adho-bot/Individual-Project/report/Final_Report_11319192.odt

Bit-Serial SIMD Array Processor for Sobel Edge Detection Applications

Third Year Individual Project – Final Report

05/2026

11319192

Supervisor:

Piotr Dudek

## Contents

## Abstract

Real time systems operate under constraints, which may include area, power or computational load. This paper introduces a custom Pixel Processor Array (PPA) for convolution operations designed for area and power optimisation whilst balancing efficiency. Bit serial architectures are employed to reduce the power and by using an array processor based on the Single Instruction Multiple Data (SIMD) paradigm, computations can be accelerated with the bottlenecks apparent within bit-serial architectures. This paper demonstrates how different image processing kernels such as Gaussian blur, sharpening can be implemented without the use of conventional convolution. Results are shown through the Vivado simulator as well as Field Programmable Gate Arrays (FPGA) and Application Specific Integrated Circuit (ASIC) implementation

… To be continued after finishing the report

## Declaration of originality

I hereby confirm that this dissertation is my own original work unless referenced clearly to the contrary, and that no portion of the work referred to in the dissertation has been submitted in support of an application for another degree or qualification of this or any other university or other institute of learning.

## Intellectual property statement

i. The author of this thesis (including any appendices and/or schedules to this thesis) owns certain copyright or related rights in it (the “Copyright”) and s/he has given The University of Manchester certain rights to use such Copyright, including for administrative purposes.
ii. Copies of this thesis, either in full or in extracts and whether in hard or electronic copy, may be made only in accordance with the Copyright, Designs and Patents Act 1988 (as amended) and regulations issued under it or, where appropriate, in accordance with licensing agreements which the University has from time to time. This page must form part of any such copies made.
iii. The ownership of certain Copyright, patents, designs, trademarks and other intellectual property (the “Intellectual Property”) and any reproductions of copyright works in the thesis, for example graphs and tables (“Reproductions”), which may be described in this thesis, may not be owned by the author and may be owned by third parties. Such Intellectual Property and Reproductions cannot and must not be made available for use without the prior written permission of the owner(s) of the relevant Intellectual Property and/or Reproductions.
iv. Further information on the conditions under which disclosure, publication and commercialisation of this thesis, the Copyright and any Intellectual Property and/or Reproductions described in it may take place is available in the University IP Policy (see http://documents.manchester.ac.uk/DocuInfo.aspx?DocID=24420), in any relevant Dissertation restriction declarations deposited in the University Library, and The University Library’s regulations (see http://www.library.manchester.ac.uk/about/regulations/_files/Library-regulations.pdf).

## Acknowledgements

No need to include, but can if want to.

# Introduction

## Background and motivation

Convolution is a key operation in many image processing tasks. Many low level convolution operations are unordered tasks, making them suitable to parallel processing architectures. Traditional 2D convolution operations (where you shift a kernel across a grid of pixels) is computationally expensive, requiring large number of multiply-accumulate (MAC) operations per second, especially for high-resolution images and deep neural networks. There is a major bottleneck in scaling Convolutional Neural Networks due to significant power consumption challenges. In data centres, large deployment requires major electrical infrastructures and cooling systems due to limited energy efficiency when implemented on GPU clusters for training and inference. These challenges are even more apparent in edge devices, where strict power and silicon area constraints limit the feasibility of convolution operations.

## Aims and objectives

-AIM (What is the goals)

Target the inefficiencies

Area

Power

Speedup

-OBJECTIVES (How to achieve these goals)

Bit serial

Parallel

How to target each trade-off and what method you are using to do so

Bit-serial and reduced arithmetic approaches offer reductions in power and area usage, however increasing the trade-off, reducing the speed-up of the system. Therefore, careful consideration to the architecture must be employed to exploit parallelism and balance memory efficiency, power and silicon area. The work aims to develop a unique Bit-serial SIMD array processor for image processing applications.

Table Introduction.1. Example table.

Participant | Number / % | | Duration / %
| Prime dresses | Non-prime dresses | Prime dresses | Non-prime dresses
1 | 33.33 | 33.91 | 20.83 | 18.42
2 | 13.04 | 17.50 | 04.93 | 07.62
3 | 22.73 | 20.10 | 13.00 | 08.20
4 | 31.34 | 21.88 | 10.57 | 11.09
5 | 08.47 | 19.32 | 03.04 | 09.73
Mean | 16.4 | 16.5 | 07.8 | 07.5
Std. dev. | 09.7 | 06.6 | 05.4 | 03.3

Donec blandit feugiat ligula. Donec hendrerit, felis et imperdiet euismod, purus ipsum pretium metus, in lacinia nulla nisl eget sapien. Donec ut est in lectus consequat consequat. Etiam eget dui. Aliquam erat volutpat. Sed at lorem in nunc porta tristique. Proin nec augue. Quisque aliquam tempor magna. Pellentesque habitant morbi tristique senectus et netus et malesuada fames ac turpis egestas.

## Report structure

Lorem ipsum dolor sit amet, consectetuer adipiscing elit. Maecenas porttitor congue massa. Fusce posuere, magna sed pulvinar ultricies, purus lectus malesuada libero, sit amet commodo magna eros quis urna.

Nunc viverra imperdiet enim. Fusce est. Vivamus a tellus.

Pellentesque habitant morbi tristique senectus et netus et malesuada fames ac turpis egestas. Proin pharetra nonummy pede. Mauris et orci.

Aenean nec lorem. In porttitor. Donec laoreet nonummy augue.

Suspendisse dui purus, scelerisque at, vulputate vitae, pretium mattis, nunc. Mauris eget neque at sem venenatis eleifend. Ut nonummy.

This is an example equation. It is done inside a table with the table lines hidden.

| {a} ^ {2} + {b} ^ {2} = {c} ^ {2} | (Introduction.1)

Lorem ipsum dolor sit amet, consectetuer adipiscing elit. Maecenas porttitor congue massa. Fusce posuere, magna sed pulvinar ultricies, purus lectus malesuada libero, sit amet commodo magna eros quis urna.

Nunc viverra imperdiet enim. Fusce est. Vivamus a tellus.

Pellentesque habitant morbi tristique senectus et netus et malesuada fames ac turpis egestas. Proin pharetra nonummy pede. Mauris et orci.

Aenean nec lorem. In porttitor. Donec laoreet nonummy augue.

Suspendisse dui purus, scelerisque at, vulputate vitae, pretium mattis, nunc. Mauris eget neque at sem venenatis eleifend. Ut nonummy.

# Literature review

## Introduction

Lorem ipsum dolor sit amet, consectetuer adipiscing elit. Maecenas porttitor congue massa. Fusce posuere, magna sed pulvinar ultricies, purus lectus malesuada libero, sit amet commodo magna eros quis urna. Nunc viverra imperdiet enim.

Fusce est. Vivamus a tellus. Pellentesque habitant morbi tristique senectus et netus et malesuada fames ac turpis egestas. Proin pharetra nonummy pede.

Mauris et orci. Aenean nec lorem. In porttitor. Donec laoreet nonummy augue.

This is an example figure.

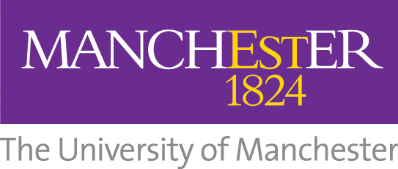
[picture p5: figure]

Fig. Literature review.1. Example figure.

## Detail

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

Nunc viverra imperdiet enim. Fusce est. Vivamus a tellus.

Pellentesque habitant morbi tristique senectus et netus et malesuada fames ac turpis egestas. Proin pharetra nonummy pede. Mauris et orci.

Aenean nec lorem. In porttitor. Donec laoreet nonummy augue.

Suspendisse dui purus, scelerisque at, vulputate vitae, pretium mattis, nunc. Mauris eget neque at sem venenatis eleifend. Ut nonummy.

## More detail

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

Nunc viverra imperdiet enim. Fusce est. Vivamus a tellus.

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

Aenean nec lorem. In porttitor. Donec laoreet nonummy augue.

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

## Summary

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

Nunc viverra imperdiet enim. Fusce est. Vivamus a tellus.

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

Aenean nec lorem. In porttitor. Donec laoreet nonummy augue.

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

# Methods

## Introduction

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

Nunc viverra imperdiet enim. Fusce est. Vivamus a tellus.

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

Aenean nec lorem. In porttitor. Donec laoreet nonummy augue.

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

## Detail

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

Nunc viverra imperdiet enim. Fusce est. Vivamus a tellus.

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

Aenean nec lorem. In porttitor. Donec laoreet nonummy augue.

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

## More detail

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

Nunc viverra imperdiet enim. Fusce est. Vivamus a tellus.

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

Aenean nec lorem. In porttitor. Donec laoreet nonummy augue.

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

## Summary

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

Nunc viverra imperdiet enim. Fusce est. Vivamus a tellus.

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

Aenean nec lorem. In porttitor. Donec laoreet nonummy augue.

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

# Results and discussion

## Introduction

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

Nunc viverra imperdiet enim. Fusce est. Vivamus a tellus.

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

Aenean nec lorem. In porttitor. Donec laoreet nonummy augue.

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

## Detail

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

Nunc viverra imperdiet enim. Fusce est. Vivamus a tellus.

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

Aenean nec lorem. In porttitor. Donec laoreet nonummy augue.

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

## More detail

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

Nunc viverra imperdiet enim. Fusce est. Vivamus a tellus.

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

Aenean nec lorem. In porttitor. Donec laoreet nonummy augue.

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

## Summary

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

Nunc viverra imperdiet enim. Fusce est. Vivamus a tellus.

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

Aenean nec lorem. In porttitor. Donec laoreet nonummy augue.

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

# Conclusions and future work

## Conclusions

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

Nunc viverra imperdiet enim. Fusce est. Vivamus a tellus.

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

Aenean nec lorem. In porttitor. Donec laoreet nonummy augue.

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

## Future work

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

Nunc viverra imperdiet enim. Fusce est. Vivamus a tellus.

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

Aenean nec lorem. In porttitor. Donec laoreet nonummy augue.

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

## References

Put references here.

## Appendices

A Project outline

Project outline as submitted at the start of the project is a required appendix. Put here.

B Risk assessment

Risk assessment is a required appendix. Put here.

C XXXX – etc.
