adho-bot/Individual-Project/Final_Report_Latex/images/Array_Architecture.pdf

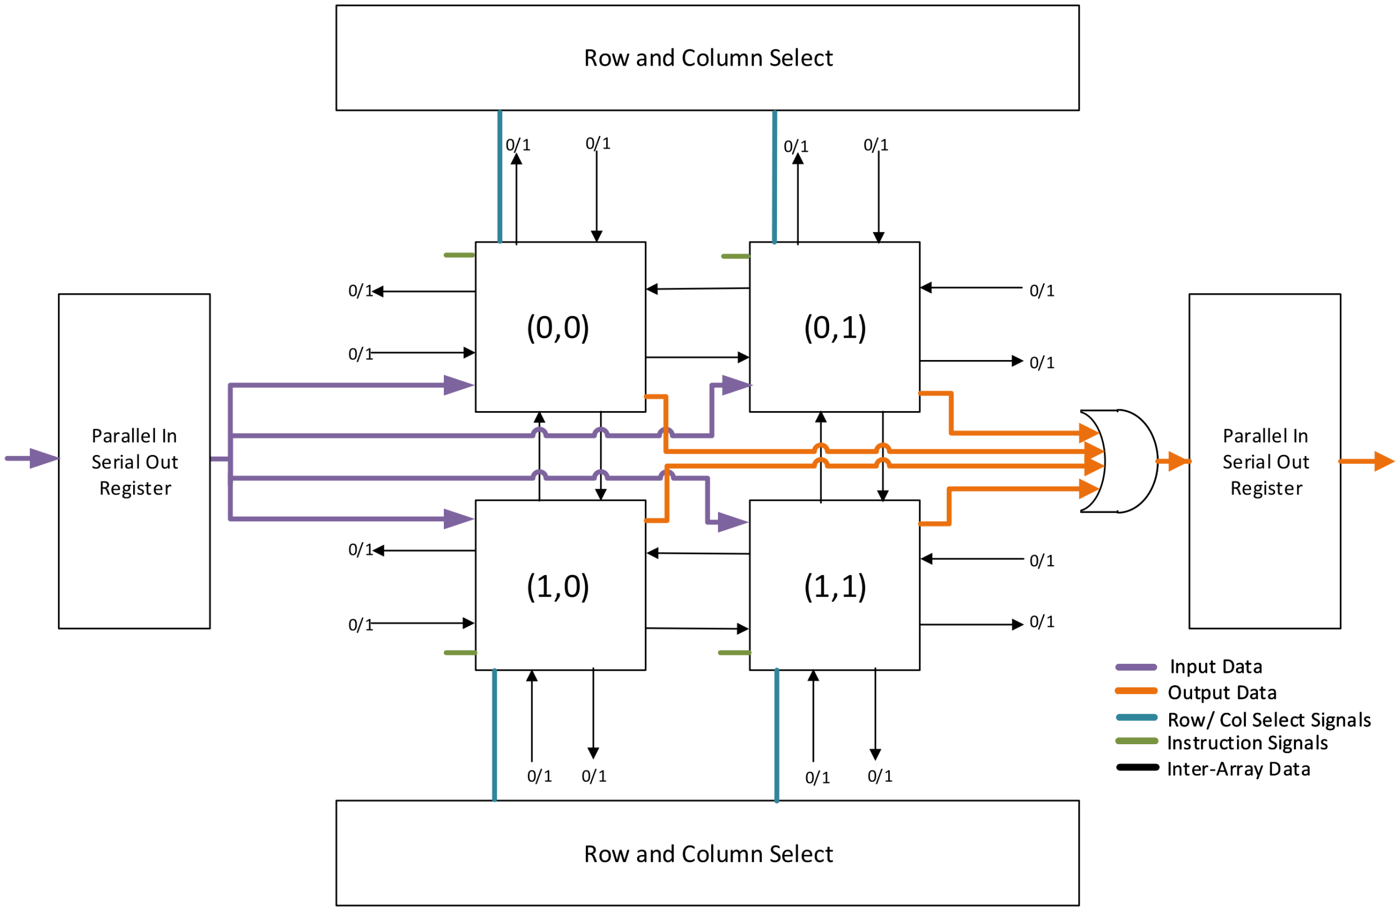
[picture p6: page 1]
