adho-bot/Individual-Project/Final_Report_Latex/images/CPD.pdf

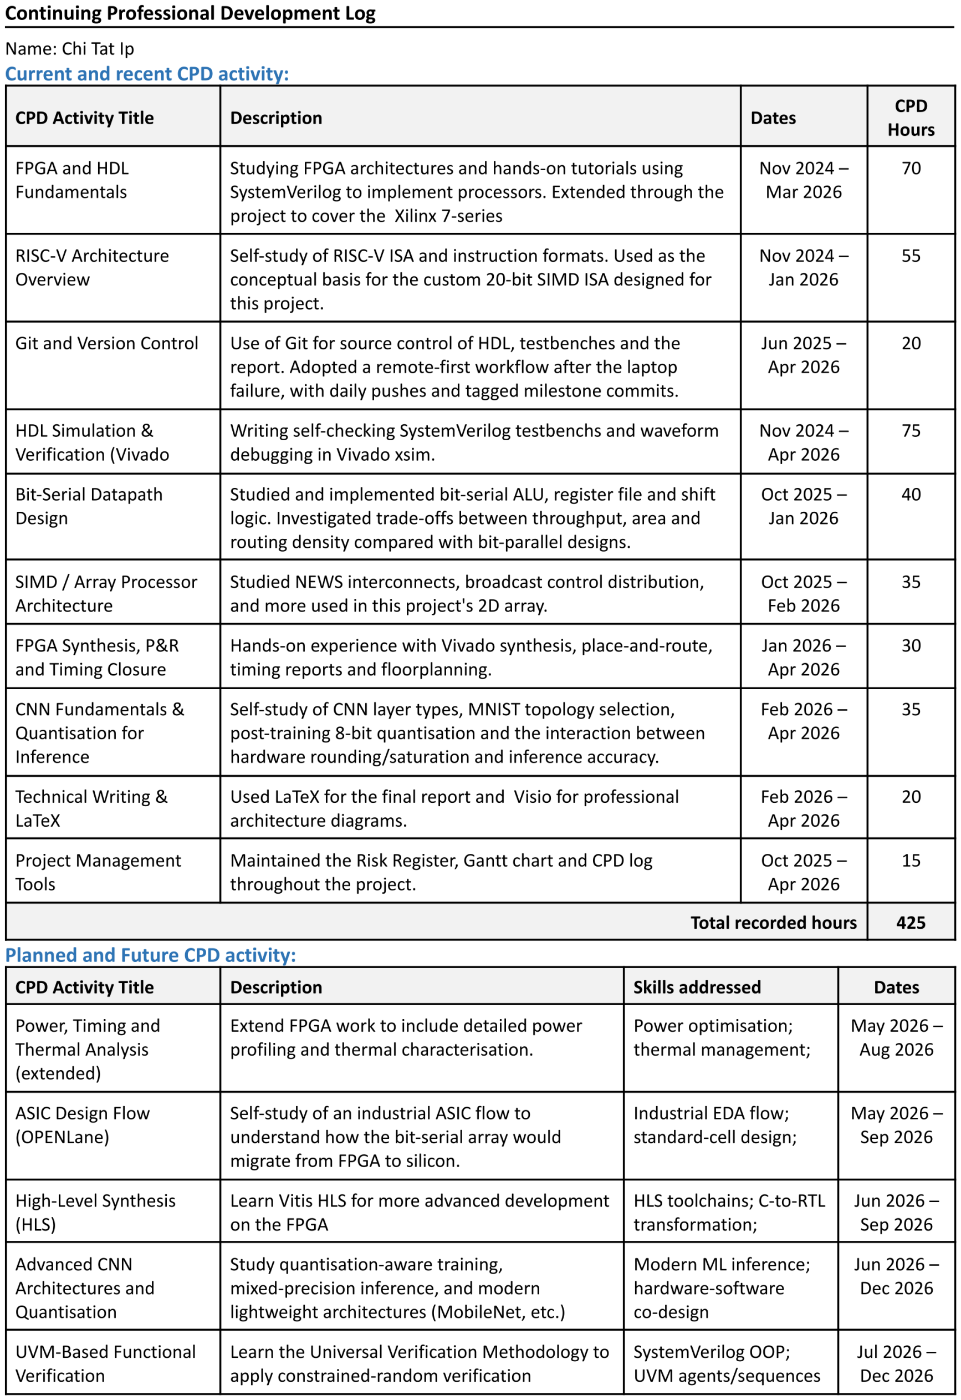
[picture p7: page 1]
