adho-bot/Individual-Project/Final_Report_Latex/images/FSM.pdf

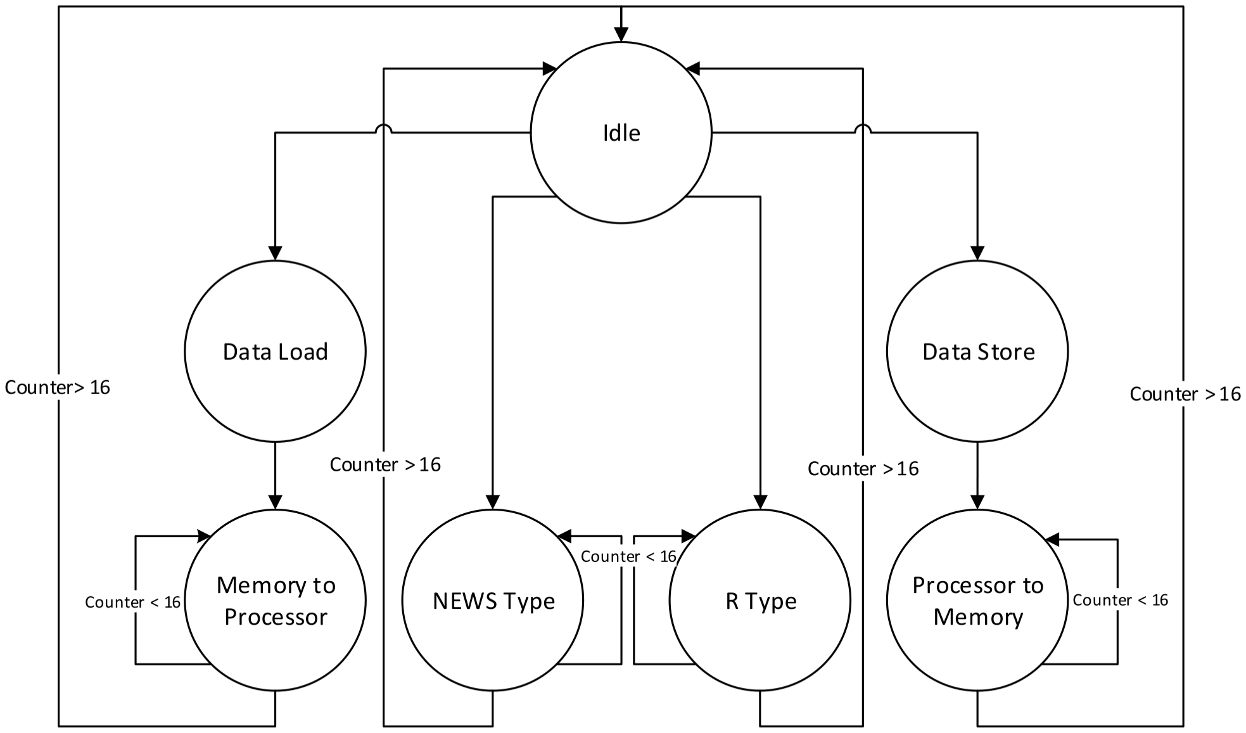
[picture p8: page 1]
