adho-bot/Individual-Project/Final_Report_Latex/images/Full_Individual_Project_Diagram.pdf

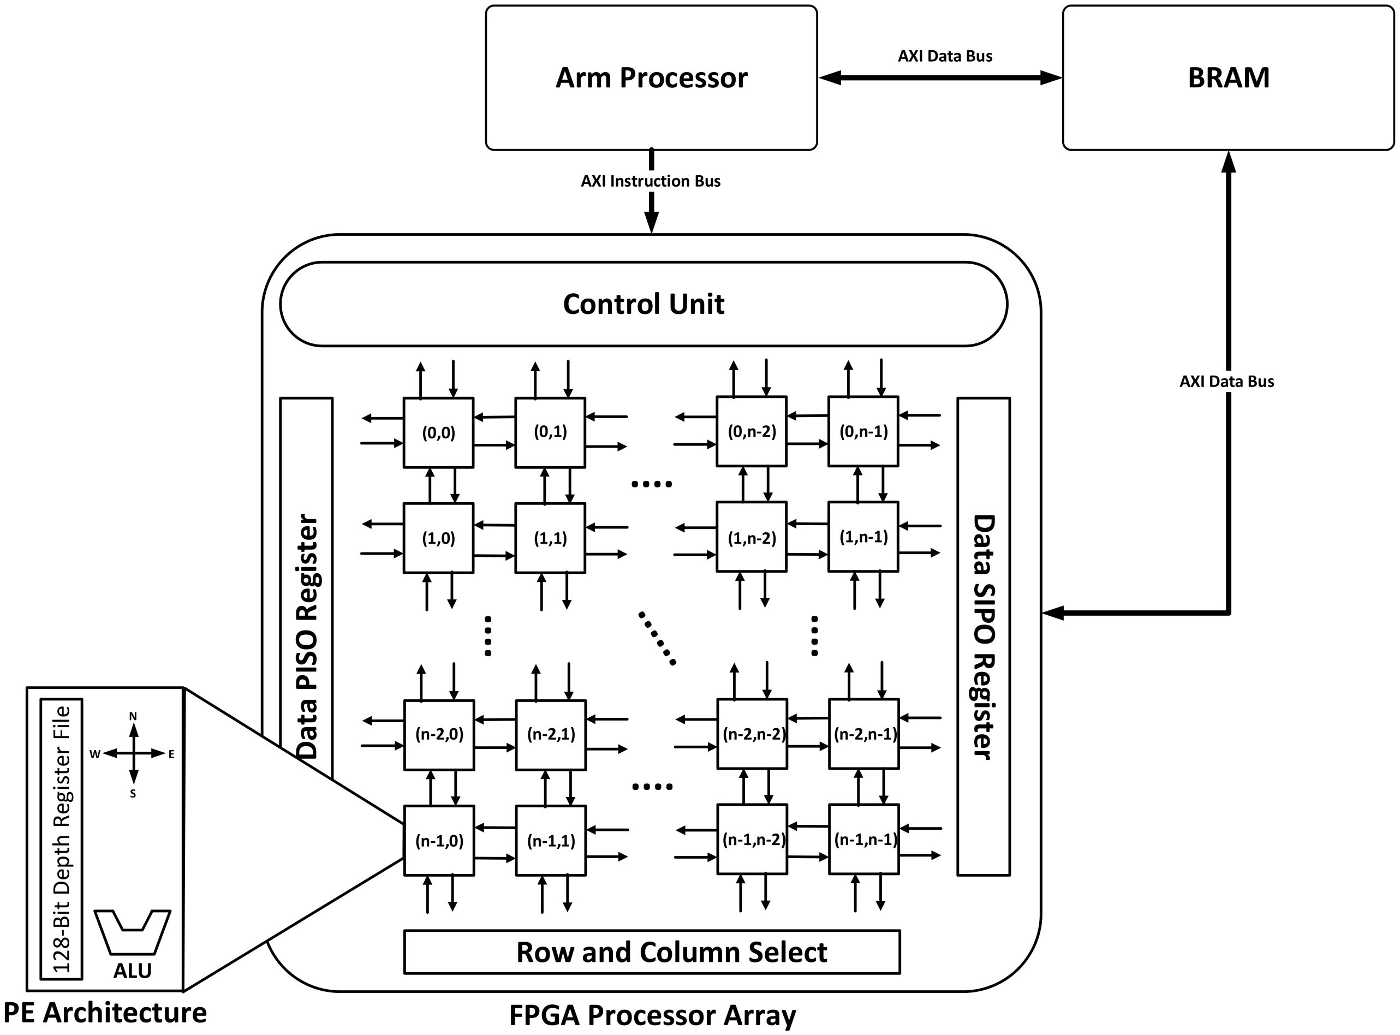
[picture p9: page 1]
