adho-bot/Individual-Project/Final_Report_Latex/images/PE_Architecture.pdf

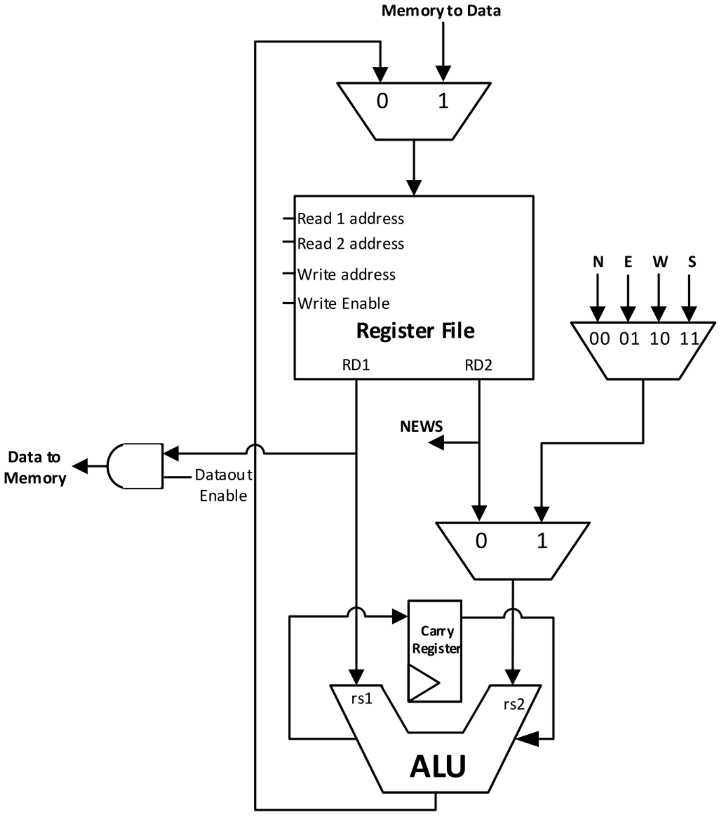
[picture p10: page 1]
