adho-bot/Individual-Project/Final_Report_Latex/images/SLICES.pdf

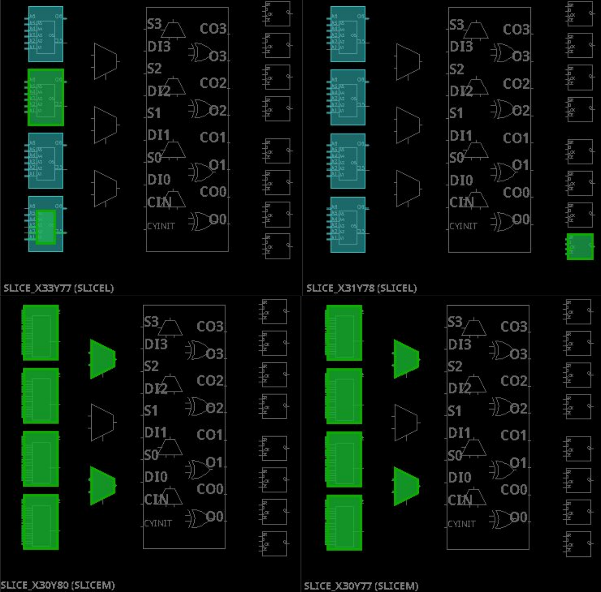
[picture p12: page 1]
