adho-bot/Individual-Project/Final_Report_Latex/images/System_Layout.pdf

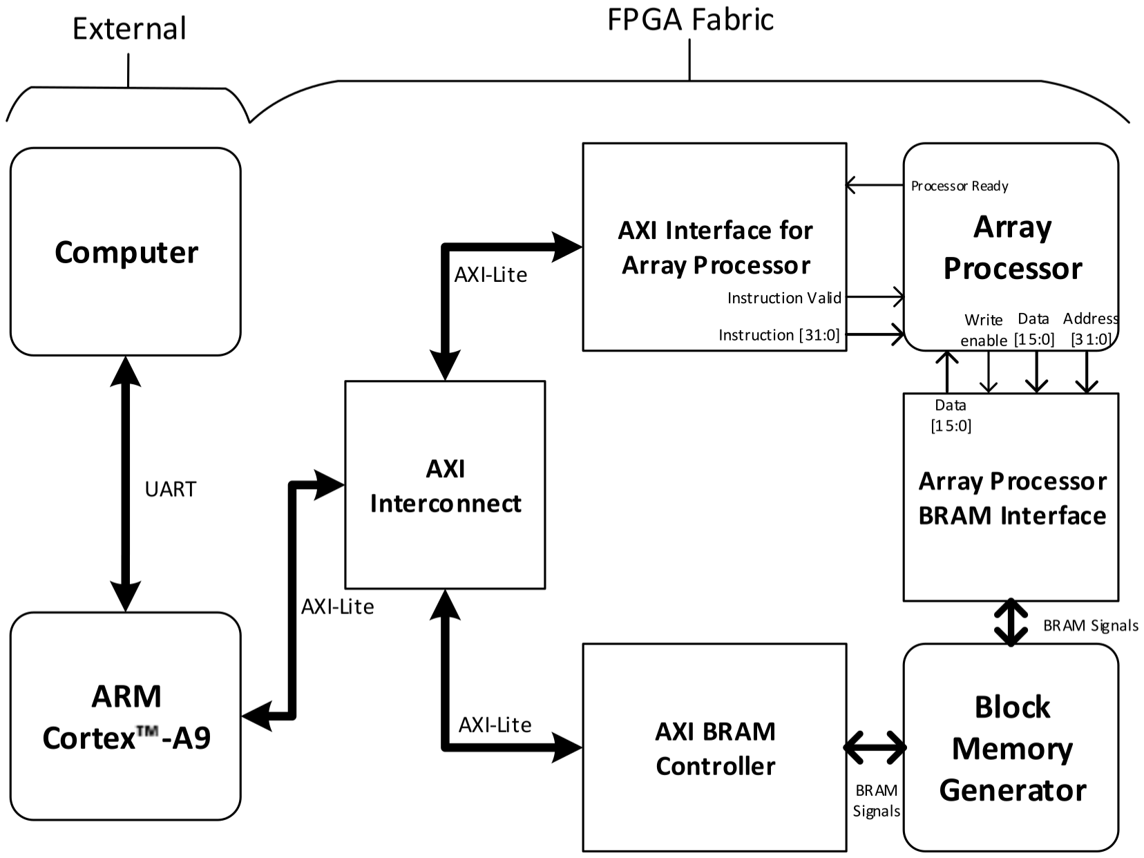
[picture p13: page 1]
