adho-bot/Individual-Project/An_Area_and_Power_Efficient_Bit_Serial_SIMD_Array_Processor_for_Image_Processing_on_FPGA.pdf

## An Area and Power-Efficient Bit-Serial SIMD Array Processor for

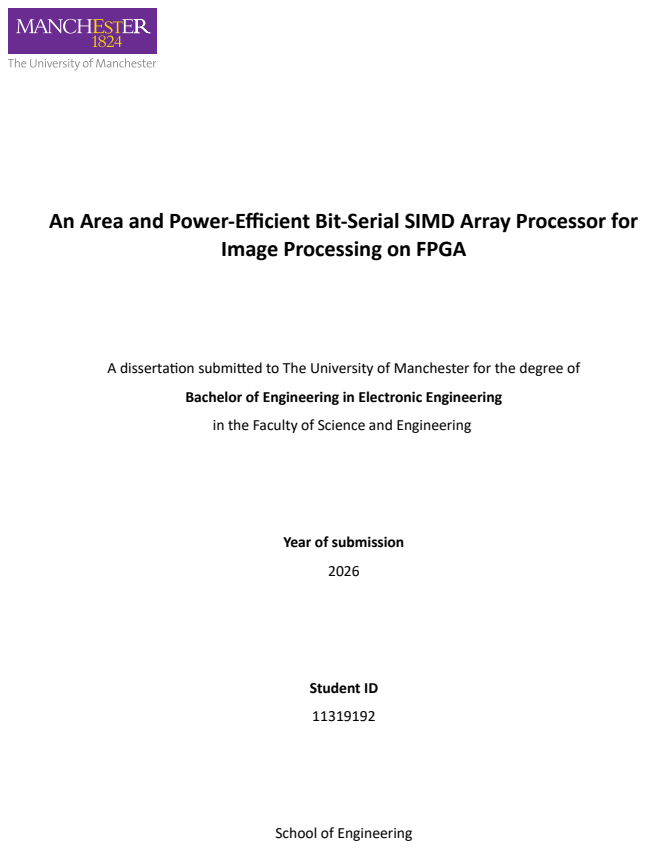
[picture p14: page 1]
Student ID

Image Processing on FPGA

A dissertation submitted to The University of Manchester for the degree of

Bachelor of Engineering in Electronic Engineering

in the Faculty of Science and Engineering

Year of submission

School of Engineering

## Contents

Word count: 11014

## Abstract

Image processing in edge-intelligent systems, such as wearable devices and remote sensors, de-

mands high throughput when operating within low power envelopes. Using conventional sequen-

tial processor architectures introduces disproportionate area and energy costs for workloads whose

parallelism is fundamentally data-level and spatial. This dissertation presents the design and anal-

ysis of a custom bit-serial SIMD array processor targeted at the optimisation of these three con-

straints for low-level image processing workloads.

The architecture exploits data-level parallelism through a two-dimensional grid of processing ele-

ments with NEWS connectivity, a 20-bit instruction set supporting movement-based convolution,

and a distributed register file mapped to LUTRAM to minimise per-PE footprint. The design is im-

plemented on a Xilinx XC7Z020 (PYNQ-Z2), characterised across five array configurations from 4 to

1024 PEs, and evaluated on Sobel edge detection and a shallow MNIST convolutional classifier. At

1024 PEs the processor delivers a word-level throughput of 2.42 GOPS at 71 MHz while consum-

ing 92 mW and occupying 47.1% of available LUTRAM and 31.7% of logic LUTs. Peak energy effi-

ciency reaches 0.0507 GOPS/mW at intermediate configurations. Three architectural bottlenecks,

the single-word memory interface, OR-tree depth, and AXI-Lite handshake latency, are quantified

with targeted architectural solutions proposed. The results demonstrate that fine-grained bit-serial

SIMD remains a competitive operating point for area and power constrained image processing on

FPGAs.

## List of figures

1 | Example labelled numbers from the MNIST dataset | | 18
2 | System and array processor overview | | 20
3 | Array Processor High Level Architecture | | 21
4 | Processing Element Datapath Architecture | | 22
5 | Finite State Machine for the Array Processor | | 24
6 | Instruction Types for the Array Processor | | 25
7 | System implementation for array processor. Important data, control and bus interface
| signals are presented. Bold arrows represent buses consisting of multiple signal types . | 27
8 | Slice composition of a single PE. Top two slices are SLICEL, bottom two are SLICEM; PE
| resources are highlighted in green neighbouring PE resources in teal | | 36
9 | Cycle distribution by FSM state for the Sobel and number-classification workloads. The
| Sobel filter is executed on the 32×32 (1024-PE) configuration; the classifier is executed
| on the 16×16 (256-PE) configuration. Arithmetic combines R-type and NEWS-type in-
| structions; I/O combines load and store; IDLE counts cycles in which no instruction is
| executing | | 37
10 | FPGA resource utilisation as a function of array size. Logic LUTs, LUTRAMs, flip-flops,
| and slices are reported for five PE configurations (4, 16, 64, 256, 1024). Lines are linear
| regressions in log–log space | | 39
11 | Theoretical peak bit-level throughput as a function of array size. The dashed line is a
| linear regression in log–log space | | 39
12 | Dynamic power consumption as a function of array size. Power is reported for the ar-
| ray and control unit only, measured using a vectorless method. The dashed line is a
| linear regression in log–log space | | 40
13 | Sobel edge detection on a 32x32 picture of an eye. Input shown on the left. Result
| shown on the right | | 41
14 | Number classification for the 16x16 digit eight. Input shown on the left. Result shown
| on the right | | 41
15 | Gantt chart for the bit-serial array processor during semester 1 | | 51
16 | Gantt chart for the bit-serial array processor during semester 2 | | 51
17 | Risk Assessment Form | | 52
18 | Risk Register | | 53
19 | Continuing Professional Development (CPD) log | | 54

## List of tables

1 | Bit-serial array processors | | 16
2 | Modern array processors | | 17
3 | Instruction Set Summary | | 26
4 | Theoretical vs Measured CPI by Instruction | | 36
5 | BRAM word-address memory map | | 57
6 | PE register allocation during CNN inference | | 58

## List of Abbreviations

ALU | Arithmetic Logic Unit
ASIC | Application-Specific Integrated Circuit
AXI | Advanced eXtensible Interface
BRAM | Block Random Access Memory
CLB | Configurable Logic Block
CNN | Convolutional Neural Network
CPI | Cycles Per Instruction
FPGA | Field-Programmable Gate Array
FSM | Finite State Machine
GOPS | Giga-Operations Per Second
ISA | Instruction Set Architecture
LUT | Look-Up Table
LUTRAM | Look-Up Table Random Access Memory
MAC | Multiply-Accumulate
MIMD | Multiple Instruction, Multiple Data
MNIST | Modified National Institute of Standards and Technology
NEWS | North, East, West, South
PE | Processing Element
PISO | Parallel-In Serial-Out
ReLU | Rectified Linear Unit
RTL | Register Transfer Level
SIMD | Single Instruction, Multiple Data
SIPO | Serial-In Parallel-Out

## Declaration of originality

I hereby confirm that no portion of the work referred to in the thesis has been submitted in sup-

port of an application for another degree or qualification of this or any other university or other

institute of learning.

## Copyright statement

i The author of this thesis (including any appendices and/or schedules to this thesis) owns cer-

tain copyright or related rights in it (the “Copyright”) and s/he has given The University of

Manchester certain rights to use such Copyright, including for administrative purposes.

ii Copies of this thesis, either in full or in extracts and whether in hard or electronic copy, may

be made only in accordance with the Copyright, Designs and Patents Act 1988 (as amended)

and regulations issued under it or, where appropriate, in accordance with licensing agree-

ments which the University has from time to time. This page must form part of any such copies

made.

iii The ownership of certain Copyright, patents, designs, trademarks and other intellectual prop-

erty (the “Intellectual Property”) and any reproductions of copyright works in the thesis, for

example graphs and tables (“Reproductions”), which may be described in this thesis, may not

be owned by the author and may be owned by third parties. Such Intellectual Property and

Reproductions cannot and must not be made available for use without the prior written per-

mission of the owner(s) of the relevant Intellectual Property and/or Reproductions.

iv Further information on the conditions under which disclosure, publication and commercial-

isation of this thesis, the Copyright and any Intellectual Property and/or Reproductions described in it may take place is available in the University IP Policy (see http://documents.
manchester.ac.uk/DocuInfo.aspx?DocID=24420), (http://documents.manchester.ac.uk/DocuInfo.aspx?DocID=24420) in any relevant Thesis restriction dec-

larations deposited in the University Library, The University Library’s regulations (see http:

## //www.library.manchester.ac.uk/about/regulations/) and in The University’s policy

on Presentation of Theses.

## Acknowledgments

I would like to thank my project supervisor Dr. Piotr Dudek for his amazing guidance and invaluable

expertise, throughout this project.

## 1 Introduction

Critical edge applications such as wearable medical devices, and remote sensors, must operate

within constrained power and space limits while responding in real time. These devices cannot rely

on processing on cloud servers because transmitting data can be slow or unreliable. Edge-intelligent

systems address this by processing data locally, allowing for fast computation whilst minimising

power and area consumption. To meet these requirements, parallel processor arrays (PPAs) and

SIMD architectures are well suited. Their grid-like structure and ability to run many calculations in

parallel make them ideal for tasks such as image processing in real-time embedded systems.

### 1.1 Background and Motivation

Image processing is the core workload of various edge systems. 2D convolution is the fundamental

operation found in low-level vision and convolutional neural network (CNN) tasks. This is where

a weighted sum of a pixel and its neighbours are repeated across the entire image. A single 3×3

convolution on a modest 256×256 image already requires over half a million multiply-accumulate

(MAC) operations, and modern CNNs scale this by orders of magnitude through multiple stacked

convolutional layers and feature channels. Executing such workloads on conventional sequential

processors is very inefficient. Pipelining, superscalar issue, and out-of-order execution all target

instruction-level parallelism, but they do not exploit the property that the same operation is ap-

plied independently to many data elements.

Single-Instruction-Multiple-Data (SIMD) array processors exploit this property directly. A grid of

processing elements (PEs) executes one shared instruction across many pixels in parallel, elimi-

nating the per-instruction fetch and decode cost. When the array is connected through nearest-

neighbour links, the spatial structure of convolution maps onto the hardware without the need for

global memory access.

### 1.2 Aims and Objectives

The aim of this project is to design, implement, and evaluate an area and power efficient FPGA-

based bit-serial SIMD array processor capable of executing image-processing workloads. Each ob-

jective is benchmarked against prior bit-serial FPGA designs (where possible) and against three cri-

teria: area efficiency (resource consumption per processing element), energy efficiency (operations per unit power, GOPS/mW), and performance (Giga Operations Per Second, GOPS). The objectives

for the design are as follows:

1. Bit-serial processing element: Design a simple processing element comprising a bit-serial ALU

supporting arithmetic and boolean logic alongside a bit-serial register file. Success is defined

as a functionally correct Processing Element (PE) that passes testcases across all supported

ALU operations and performs proper reads and writes to the register file, while achieving a

per-PE slice and Look-Up-Table (LUT) footprint competitive with prior bit-serial FPGA designs.

2. Scalable NEWS-connected array: Replicate the PE into a two-dimensional grid with North,

East, West, South (NEWS) connectivity, with a configurable boundary padding scheme and PE

activity gating for inactive elements. Success is defined as fitting a large array configuration,

sized against current bit-serial processors, within the available resources, delivering through-

put in GOPS that scales with PE count while keeping dynamic power consumption (in mW)

low enough to yield a competitive GOPS/mW figure.

3. Hardware control unit and instruction set architecture: Develop an FSM-based controller

with a minimal instruction set sufficient to run complex workloads, sequence bit-serial PE ex-

ecution, and provide a ready/valid handshake to the host. Success is defined as full ISA cov-

erage through workload execution, with the controller correctly driving all datapath control

signals.

4. ARM-host system integration: Connect the array processor to the ARM Cortex-A9 on the PYNQ-

Z2 using AXI-Lite for instruction delivery and a true-dual-port BRAM for data exchange. Suc-

cess is defined as a working host-accelerator system in which C programs running on the ARM

core can issue instructions and read back results, with the integration logic fitting within the

target device alongside the full array.

5. Application demonstration and evaluation: Implement two image processing workloads on

the completed system: a 3x3 Sobel edge-detection filter and a shallow convolutional neural

network for MNIST digit classification. Success is defined as both workloads producing the ex-

pected results: visible edges in the Sobel output and predicted digits matching the input la-

bels.

### 1.3 Report Structure

Section 2 examines the different approaches taken by researchers who have built SIMD processors,

based on a review of the literature. Section 3 describes the methodology in detail, including the

processor architecture, as well as the instruction set, control mechanisms, system architecture and

image processing algorithms. Section 4 presents benchmarking results, bottleneck discussion and

a threats-to-validity analysis. Section 5 goes through the different management techniques used,

such as Gantt charts, risk registers and CPD logs, to monitor progress and ensure the project re-

mained on schedule. Finally, Section 6 summarises the findings from all sections and discusses po-

tential future improvements.

## 2 Literature review

### 2.1 Introduction

Conventional sequential processors are designed to execute instructions one at a time. Improve-

ments to the traditional processor have been made to accelerate data throughput and instruction

execution. Techniques such as pipelining, superscalar and out of order execution have been utilised,

however, these approaches primarily target instruction level parallelism and not data level par-

allelism. Array processors are built upon the SIMD paradigm described in Flynn’s Taxonomy [1],

where multiple PEs act upon different pieces of data based on a single shared instruction stream.

This architecture is designed to perform high-throughput computations on large data arrays through

exploiting data level parallelism for tasks like image processing. Common types of SIMD processors

include array processors, pipelined processors, and associative processors. [2]

Array processors contain a regular structure of Processing Elements (PE). Each PE typically contains

a local register or memory, an arithmetic logic unit (ALU), and commonly north, east, south, west

cardinal communication channels to neighbouring PEs. This allows for efficient local data move-

ment without relying on slower global memory accesses as large amounts of data can be computed

within the PEs without the need for loading and storing to memory. These architectural features

make array processors highly suitable for operations that involve spatial computations, where the

resultant values depend on the current pixel as well as its neighbours. This dissertation will focus

on architectures related to the SIMD array processor.

### 2.2 A Review of SIMD Array Processors

Over the decades, SIMD array architectures have evolved from bit-serial designs to more complex

word-parallel architectures capable of performing more sophisticated arithmetic operations and

tasks. Differences in PE count, clock frequency, local memory size, and interconnect topology play

a critical role in determining the performance and efficiency of each implementation. Examining

these metrics shows that improvements have been made toward greater scalability, computational

efficiency, and suitability for image processing workloads.

### 2.2.1 Performance Metrics and Architectural Features of Past Arrays

Several early array processors were designed around the bit-serial SIMD paradigm, where each PE

operates on one bit per clock cycle, requiring multiple cycles to complete even a basic 8-bit arith-

metic operation. This architectural trade-off was made intentionally. Through reducing the width of

the buses within the PE, the effective area was reduced, allowing designers to integrate more PEs

into a processor. The processors introduced in Table 1 follow the bit-serial SIMD execution model.

The latency of data movement between PEs is highly dependent on the interconnect topology. The

Massively Parallel Processor (MPP) [3], Geometric Arithmetic Parallel Processor (GAPP) [4], and Dis-

tributed Array Processor (DAP) [5] utilise a mesh connectivity topology, with each PE being con-

nected to four of its neighbours. While being simple to implement, it was only efficient for local

operations as shifting data across the array was computationally expensive. On the other hand,

CM-1 [6] and CM-2 [7] used a hypercube routing method, organising PEs across an n-dimensional

binary cube, thus reducing the hop count between distant nodes. In the 65,536-PE CM-2, a 16-

dimensional hypercube meant the worst-case inter-PE distance was 16 hops, compared to 510 for

the mesh topology.

The GAPP ran at 0.0576 GOPS with 144 PEs on a single chip with 128 bits of local memory. It was

intended for embedded image processing applications, hence the architecture focused on area and

power consumption. The DAP increased the number of PEs and local memory size to 4,096, conse-

quently, increasing the throughput to 0.759 GOPS compared to the GAPP.

The MPP was a 128 x 128 mesh with 1K bits of local storage per PE. It reached 6.555 GOPS at 10

MHz on 8-bit data. The CM-1 followed in 1985, with 65,536 PEs connected by a hypercube topol-

ogy, 5 MHz clock frequency but increasing the throughput to 8 GOPS. The CM-2 retained the same number of PEs with a slightly increased clock frequency compared to the CM-1 but drastically in-

creased its throughput to 45.8 GOPS. due to the addition of floating-point chips (one per 32 PEs).

This showed that dedicated arithmetic hardware offered more than simply increasing the number

of PEs.

Table 1. Comparison of past bit-serial SIMD array processors for 8-bit processing.

Processor | Processing
| Elements | Clock (MHz) | PE Local
| | | Memory | Interconnect | Throughput
| | | | | (GOPS)
MPP | 16384 | 10 | 1K bits | 2D mesh | 6.554
CM-1 | 65536 | 5 | 4K bits | Hypercube | 8
CM-2 | 65,536 | 7 | 64K bits | Hypercube | 45.86
GAPP | 144 | 10 | 128 bits | 2D mesh | 0.0576
DAP | 4096 | 5 | 4096 bits | 2D mesh | 0.759

### 2.2.2 Performance Metrics and Architectural Features of Modern Arrays

Most modern parallel accelerators have shifted from the SIMD model of the historical arrays to

MIMD or hybrid execution, driven by the workload diversity of machine learning training and infer-

ence [8], [9]. The Graphcore GC200 [8], [10] integrates 1,472 independent multi-threaded tiles con-

nected through a stateless all-to-all fabric, delivering 250 TFLOPS at FP16 with 900 MB of on-chip

SRAM. The Cerebras WSE-2 [11], [12] occupies the opposite extreme: 850,000 MIMD tiles in a 2D

mesh on a single 46,225 mm² wafer, sustaining 7.5 PFLOPS. The SambaNova SN40L [9], [13] adopts

a coarse-grained reconfigurable dataflow architecture, delivering 638 TFLOPS through a compiler-

configured interconnect. SCAMP-5 [14] is the principal exception to the MIMD trend: a 256x256

SIMD array of 65,536 mixed-signal PEs delivering over 500 GOPS at sub-watt power through tightly

integrated sensing, memory, and compute.

Table 2 summarises these designs. Of these, only SCAMP-5 is a direct architectural comparator to

the present work; the others are included to characterise the broader landscape and the design

pressures that motivated the shift away from SIMD.

Table 2. Comparison of modern array processors.

Processor | PEs | Clock (MHz) | PE Local
| | | Memory
Interconnect | Throughput
SCAMP-5 [14] | 65,536 | 10 | 20 registers | 2D mesh | 0.655 TOPS
GC200 [8] | 1,472 | 1,330 | 624 KiB | All to all | 250 TFLOPS
WSE-2 [11] | 850,000 | ∼850 | 48 KB | 2D mesh | 7,500 TFLOPS
SN40L [13] | 1,040 | ∼1,000 | 520 MB
| | | Shared | Reconfig-
| | | | urable | 638 TFLOPS

### 2.2.3 Bit-Serial SIMD on FPGA

A small number of works have explored bit-serial SIMD specifically on FPGA, occupying a design

point distinct from both the historical ASIC arrays of Section 2.2.1 and the modern accelerators

of Section 2.2.2. Walsh and Dudek [15] present a 32x32 bit-serial SIMD array on a Xilinx Virtex-

5 (XC5VLX50), with each PE encapsulated in two CLBs (four slices) and connected through four-

neighbour NEWS topology. The design operates at 150 MHz and achieves a peak bit-serial through-

put of 153.6 GOPS, demonstrating binary and 8-bit greyscale image processing. The architecture

targets compactness and raw frequency, and serves as the most direct comparator to the work pre-

sented in this dissertation.

SPAR-2 [16] and its successor IMAGine [17] take a different approach, pairing bit-serial ALUs with

distributed BRAMs as a processing-in-memory overlay rather than a NEWS-connected mesh. SPAR-

2 is a programmable overlay for machine learning workloads on edge FPGAs, while IMAGine reaches

737 MHz on AMD Alveo U55 hardware with 64K bit-serial MAC units, optimised for matrix-vector

operations rather than pixel-parallel image processing.

### 2.2.4 Comparison Between Array Implementations

Three key trends emerge when comparing the architectures surveyed in Sections 2.2.1–2.2.3. First,

modern designs trade PE count for more complex PEs. The GC200 delivers over many orders of

magnitude greater throughput than the MPP with fewer than one-tenth the PE count, although the

comparison is across different precision regimes (FP16 versus 8-bit integer). Second, the choice of

interconnect reflects the type of workload performed. 2D mesh architectures scale well in hardware, but they introduce communication delays between distant PEs. This is acceptable for locally

connected tasks like CNNs (e.g., SCAMP-5 and WSE-2), where most data stays nearby. However,

it becomes inefficient for operations that require all-to-all communication, like the GC200’s cross-

bar and the SN40L’s reconfigurable interconnect. Third, on-chip memory capacity has become the

principal architectural differentiator. Off-chip DRAM accesses cost two to three orders of magni-

tude more energy per byte than SRAM [18] as well as possessing a longer data fetch latency. Bit-

serial SIMD designs sidestep this trade-off by keeping data local to each PE, with movement han-

dled through nearest-neighbour connectivity. The work presented in this dissertation is therefore

not designed to compete with the modern accelerators of Section 2.2.2. It positions itself most

directly against the FPGA bit-serial designs of Section 2.2.3, against which it is quantitatively com-

pared in Section 4.6.

### 2.3 MNIST and Convolutional Neural Networks

The Modified National Institute of Standards and Technology (MNIST) database is a collection of

grey-scale images of handwritten digits. Constructed by LeCun et al. from the larger NIST Special

Databases 1 and 3, each digit is contained within a 20x20 box, and centred by mass within a 28x28

canvas [19]. The final dataset contains 60,000 training and 10,000 test examples, labelled with num-

bers ranging from 0 to 9 [20]. Its compact size and well-established baselines make it perfect for

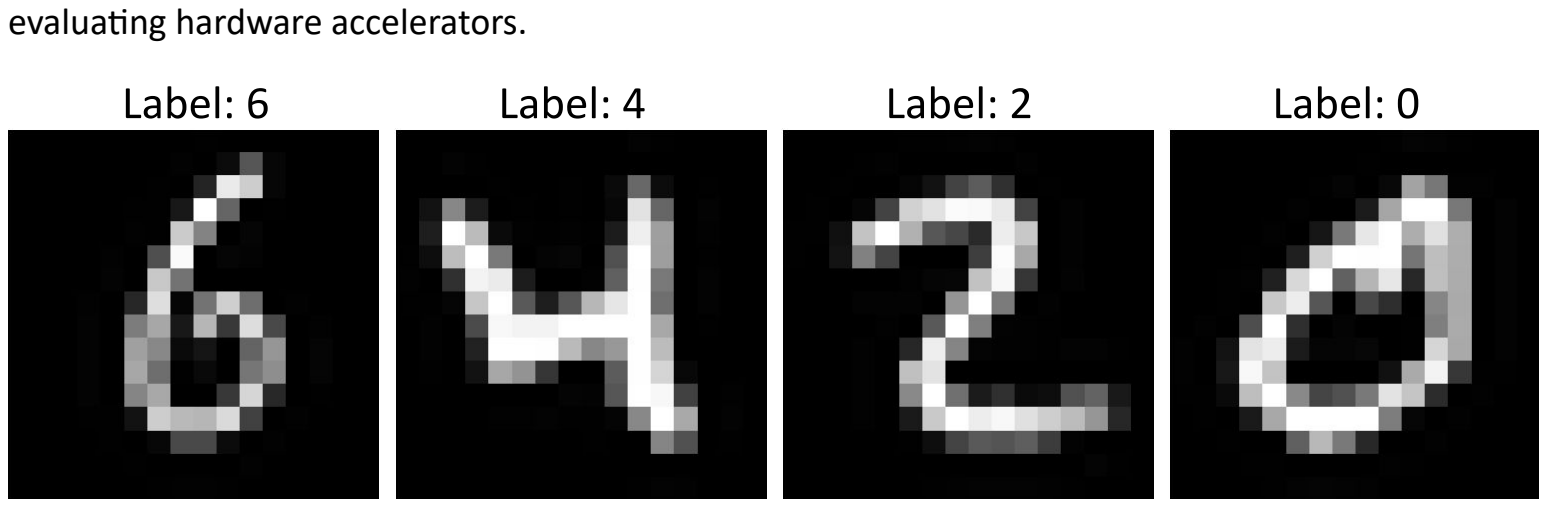
[picture p15: figure]
evaluating hardware accelerators.

Fig. 1. Example labelled numbers from the MNIST dataset

Convolutional Neural Networks (CNNs), trained end-to-end using back-propagation, make use of

the spatial structure in image data through three key ideas: local receptive fields, shared weights,

and spatial subsampling [19]. A classic example is LeNet-5, introduced by LeCun et al. in 1998, which

combines convolutional and subsampling layers with fully connected layers for classification. It

achieves less than 1% error on the MNIST dataset [19].

The computation in CNNs is mainly made up of regular multiply–accumulate operations applied

across 2D feature maps. This structure maps well onto a SIMD array, since the same operation is

repeated independently across many pixels. In this design, the NEWS interconnect is used to pass

data between neighbouring PEs, avoiding the need for global memory accesses during convolution.

In addition, the bit-serial datapath allows precision to be adjusted depending on the layer, trading

accuracy for performance when needed. Since MNIST inference is known to be robust to reduced

precision, it is a suitable benchmark for evaluating the array processor, as discussed in Chapter 4.

### 2.4 PYNQ-Z2 Architecture

The PYNQ-Z2 is the chosen development board for this project, pairing a 650 MHz dual-core ARM

Cortex-A9 with a Xilinx Zynq-7020 FPGA fabric containing 53,200 Look-Up Tables (LUTs), 106,400

flip-flops, and 140 Block RAMs [21].

The Zynq-7020 uses Xilinx’s Advanced Silicon Modular Block (ASMBL) architecture, in which Config-

urable Logic Blocks (CLBs) are organised in columns alongside dedicated BRAM and DSP resources

to improve routing efficiency [22]. Each CLB contains two slices, and slices come in two variants:

SLICELs provide LUTs, flip-flops, multiplexers, and carry logic, while SLICEMs additionally allow their

LUTs to be configured as shift registers or distributed RAM (LUTRAM) [22].

The SIMD array processor is synthesised entirely within the programmable logic, with each PE mapped

onto LUT and flip-flop resources and inter-PE communication routed through the fabric. As the

array scales, routing complexity and placement constraints become significant factors affecting

achievable frequency and resource utilisation.

### 2.5 Summary

The literature review in this chapter demonstrates the evolution of parallel processing architec-

tures from early bit-serial SIMD array processors to modern large-scale heterogeneous accelera-

tors. While early designs prioritised simplicity and dense arrays of PEs, modern systems have shifted

towards higher clock frequencies, deeper memory hierarchies, and more complex interconnects to

achieve greater overall throughput.

Despite these advances, data-level parallelism remains a fundamental principle across all archi-

tectures, particularly in workloads such as image processing and convolutional neural networks.

However, existing approaches often trade architectural simplicity, power and area for performance,

making them less suitable for edge applications where processors have to work under heavy con-

straints.

Furthermore, while FPGA-based accelerators provide a flexible platform for implementing custom

parallel architectures, they are constrained by limited on-chip resources, routing complexity, and a

lack of domain-specific optimisation, all of which limit achievable PE density.

This project addresses these gaps by implementing and evaluating a bit-serial SIMD array processor

on an FPGA, focusing on its scalability, resource efficiency, and maintaining high performance for

convolutional workloads such as MNIST inference.

## 3 Methods

### 3.1 Introduction

A simple overview of the entire system is shown in Figure 2.

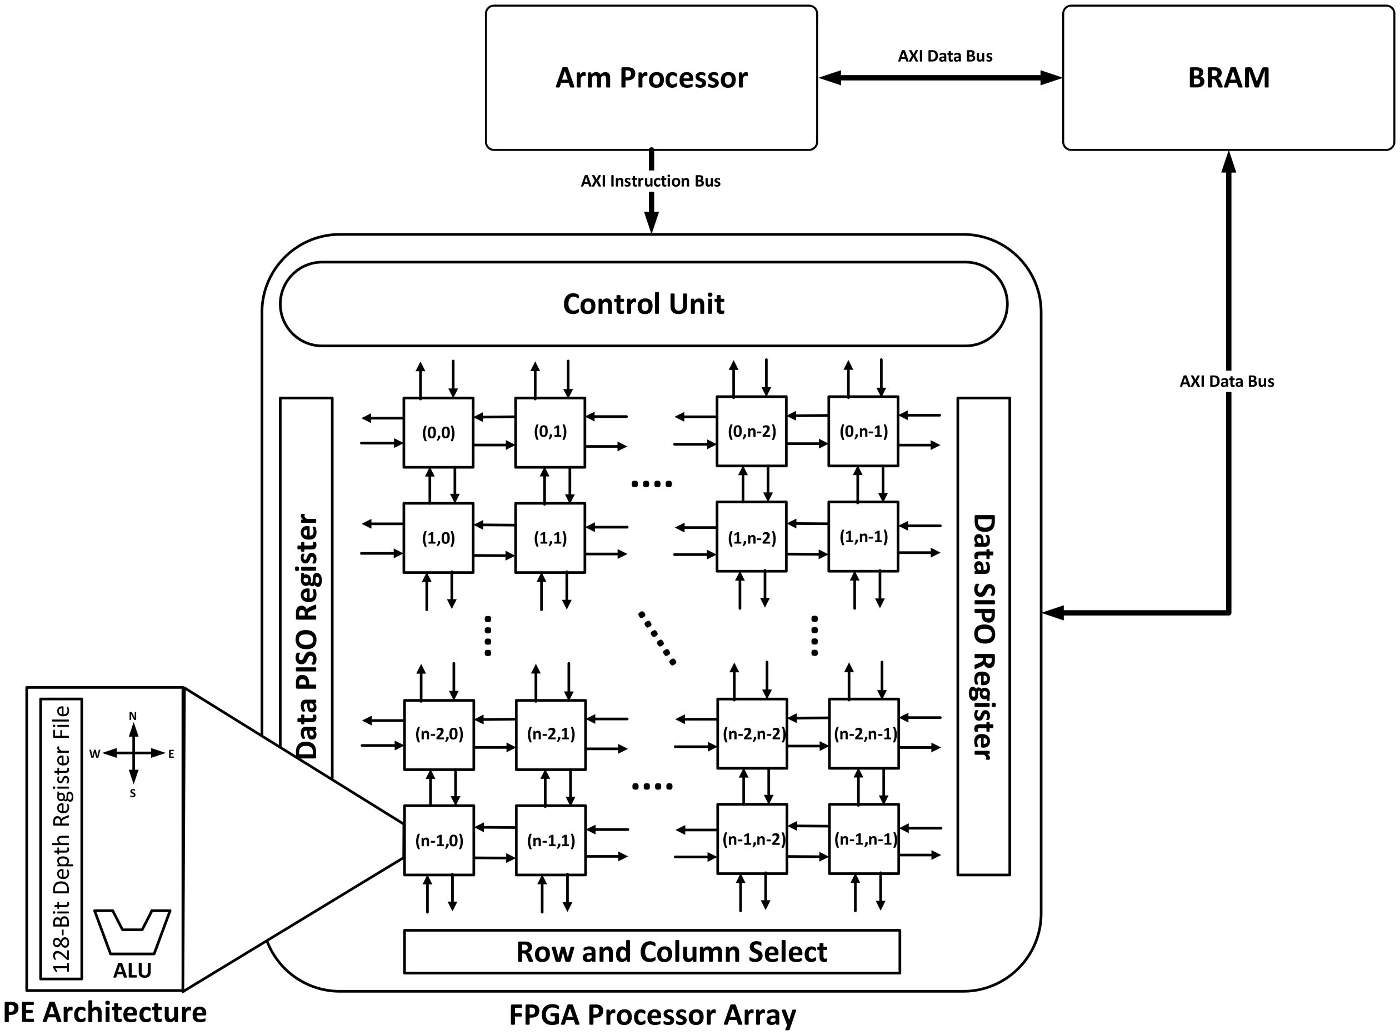
[picture p16: figure]

Fig. 2. System and array processor overview

The processor consists of a grid of bit-serial PEs with NEWS connectivity driven by a hardware con-

trol unit. The control unit decodes 20-bit instructions and broadcasts control signals to all PEs. Each

PE contains a bit-serial ALU, a register file, and a NEWS multiplexer for inter-PE communication, and

is individually gated so inactive PEs do not contribute to dynamic power. An ARM processor issues

instructions over an AXI instruction bus, while both the ARM and the array access shared BRAM via

separate AXI data buses.

### 3.2 Array Architecture

The array (shown in Figure 3) consists of a 2D grid of PEs and enabling scaling only in sizes that are

powers of two. Each PE is connected to its four immediate neighbours and communicates via the

North, East, West, and South (NEWS) channels. Boundary PEs can be supplied with zeros or ones.

Input data, stored in 16-bit words in memory, is converted to a bit-serial format using a Parallel-

In Serial-Out (PISO) register and fed into the array processor. A row and column select unit enables

the selected PE to receive the data. The output data from the PEs are captured using an OR-reduction

tree connected to a Serial-In Parallel-Out (SIPO) register.

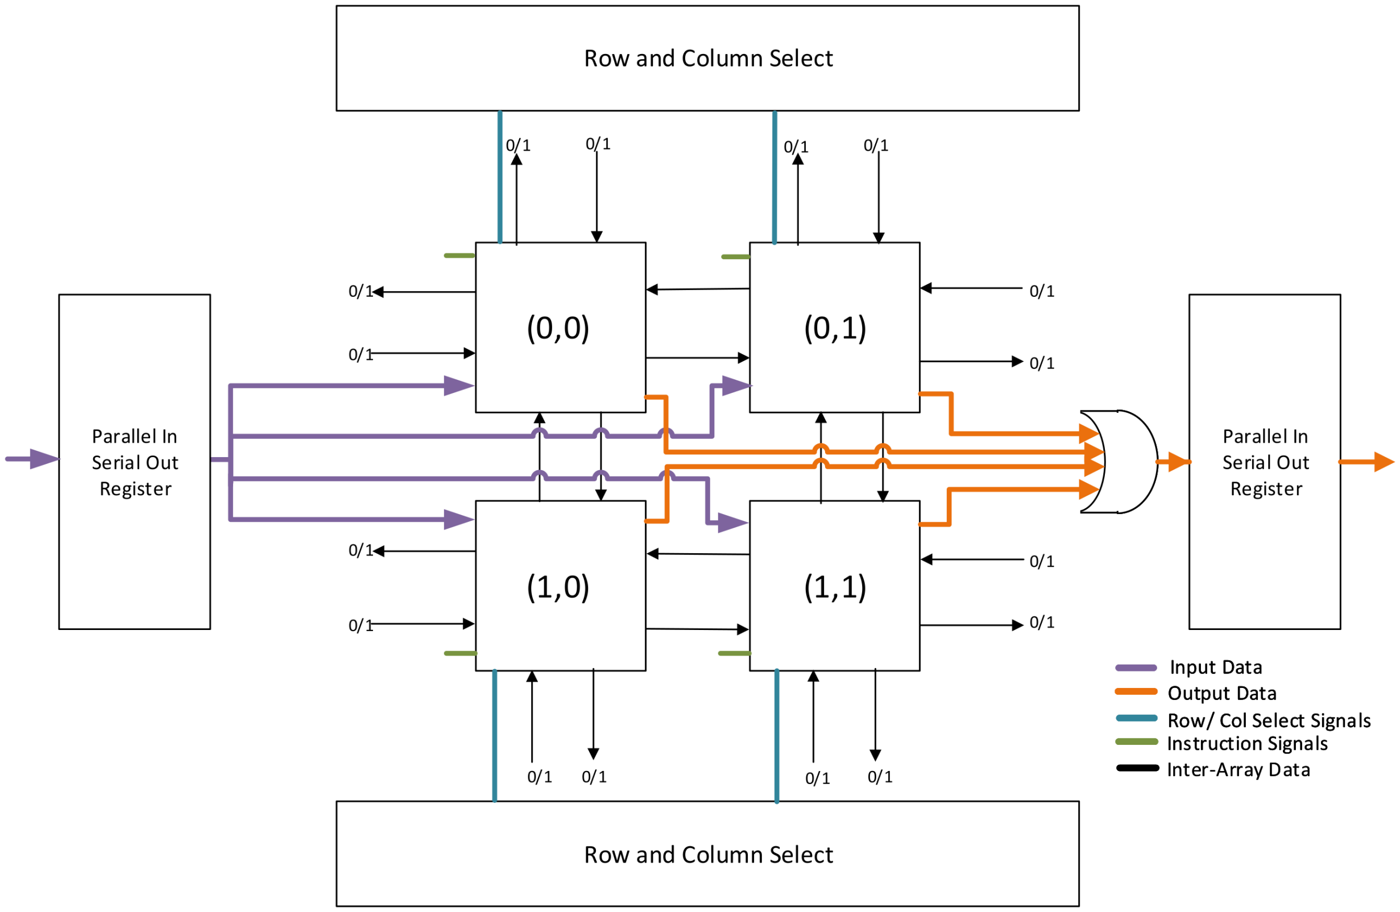
[picture p17: figure]

Fig. 3. Array Processor High Level Architecture

The array implements pixel-parallel processing, assigning one pixel to each PE. For larger images, increasing the number of PEs to match the number of pixels can significantly improve data through-

put. However, if the image size is smaller than the processor array, adding more PEs does not yield

additional throughput. Conversely, if the number of PEs is smaller than the number of image pixels,

processing time increases proportionally to the ratio of pixels to PEs. It is important to note that

increasing the number of PEs also increases power consumption and overall resource utilization.

### 3.3 Processing Element

All elements within each PE are implemented with bit-serial design principles. Each PE consists of

an Arithmetic Logic Unit (ALU) and its own register file as shown in Figure 4.

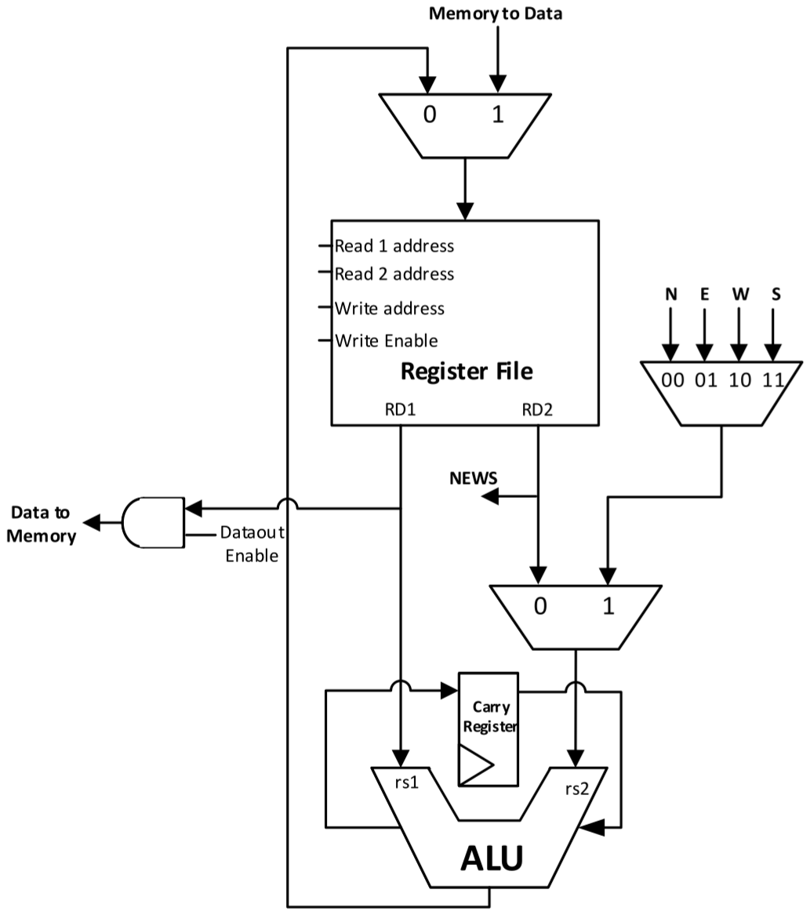
[picture p18: figure]

Fig. 4. Processing Element Datapath Architecture

### 3.3.1 Arithmetic Logical Unit

The ALU performs addition starting from the least-significant bit (LSB). It implements the funda-

mental Boolean operations AND, OR and XOR. A full-adder structure is used for both addition and

subtraction operations. Due to the bit-serial constraint of the architecture, the carry-out must be stored in a register and fed back as the carry-in for the next clock cycle, allowing carry propagation

across word bits over multiple cycles.

### 3.3.2 Register File

The register file is implemented in a bit-serial manner, organised as a one-dimensional structure

with a depth of 128. This is done in a manner which allows the Vivado synthesis tool to infer LU-

TRAM with minimal resources. Individual bits are selected combinationally using a shared global

counter as the bit index, which increments from 0 to 15 to extract a complete word LSB-first over

16 cycles.

Two independent read ports are provided through combinational indexing. The first port supports

arithmetic shift right function (SRA) by offsetting the bit index by a configurable shift amount to

replicate the sign bit. The second port includes a bit-test mode (GETMSB) that bypasses the counter

and stores 16 copies of the Most Significant Bit (MSB) into the destination register.

Write operations share the same global counter as the bit index. When write enable is asserted,

the incoming serial data bit is stored at the counter-indexed position within the destination register.

Register zero is protected by gating the write enable.

### 3.4 Control Unit

The control unit controls the data path and PE activities by generating the appropriate control sig-

nals for data path components such as the ALU, register file, memory subsystem, and inter-PE com-

munication network, in accordance with the current instruction, while enforcing deterministic tim-

ing for each instruction class to ensure correct synchronisation and predictable execution across

the architecture. The control unit is implemented in hardware and comprises a finite state machine

(FSM) that sequences the instruction through its various execution stages, and a control decoder

that generates the appropriate control signals based on both the current instruction and its execu-

tion state.

### 3.4.1 Control Finite State Machine

The Control FSM, as shown in Figure 5, is responsible for sequencing instruction execution. Each

state transition occurs on the rising edge of the clock and returns to an idle state upon an active-

low reset.

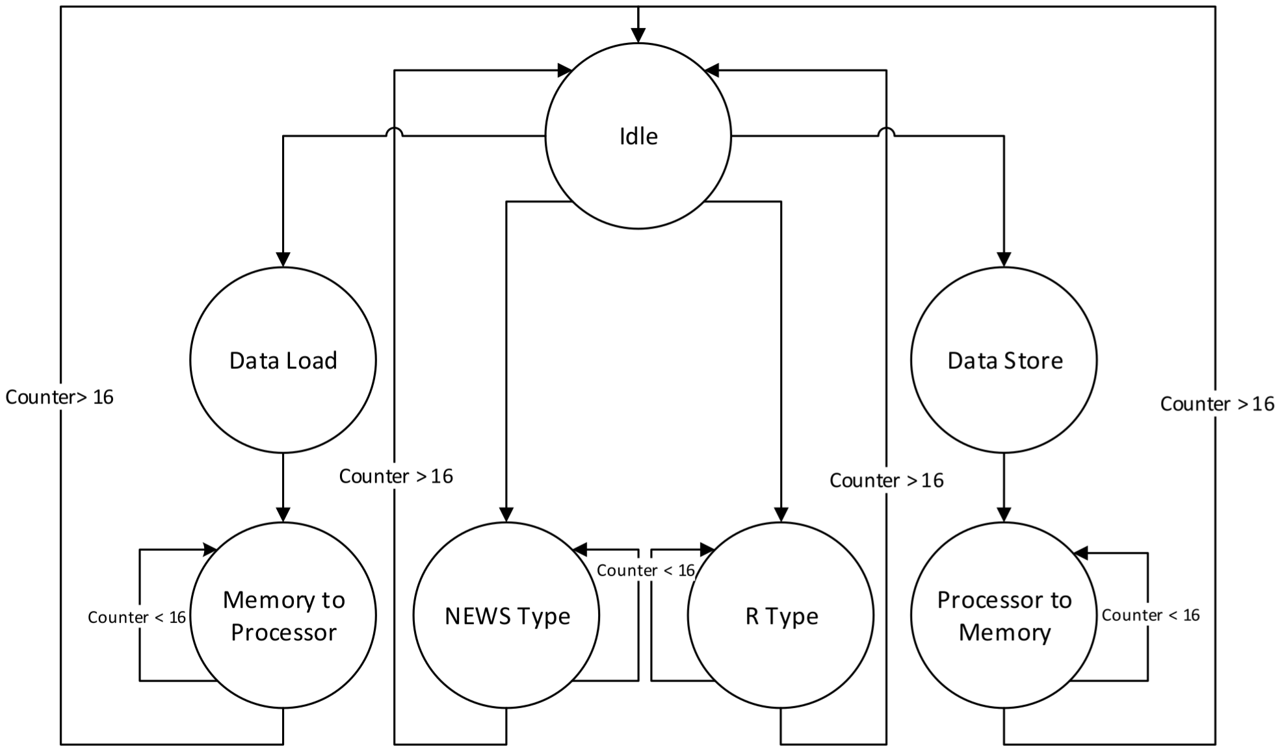
[picture p19: figure]

Fig. 5. Finite State Machine for the Array Processor

In the controller’s idle state it inspects the opcode field, transitioning if it matches that of a specific

instruction class and data valid signal is high. The data-valid signal, asserted by the ARM processor,

indicates that a new instruction is ready. The supported instructions include load, store, arithmetic

type (R-Type), and an inter-PE communication type (NEWS type).

Multi-cycle instructions are managed using the global counter. During execution phases that re-

quire iterative processing, the counter increments on each clock cycle. Once 16 cycles have been

completed, the instruction execution has completed and a new instruction is ready to be received

For I/O operations (loads and stores), the control flow includes intermediate stages to manage data

transfer between memory and the internal data-path. This is because an additional clock cycle is

required for loading of PISO and SIPO registers before data enters/exits the array.

A ready signal is asserted only when the FSM is in the idle state, providing a handshake mechanism

for external logic. This ensures that new instructions are issued only when the controller has com-

pleted the previous operation.

### 3.4.2 Control Decoder

The Control Decoder generates the control signals required to drive the data-path components.

This is based on the current execution state provided by the Control FSM and the fields of the active instruction. While the FSM determines when a particular phase of execution occurs, the de-

coder determines how the data-path should behave during that phase.

During load operations, the decoder asserts the memory read control and generates the appropri-

ate array memory address from the instruction’s immediate field. Data retrieved from memory is

first parallel-loaded into a shift structure and then serially shifted into a select PE’s destination reg-

ister over multiple cycles.

For store operations, the decoder enables serial shifting of register data into the SIPO register be-

fore asserting a memory write control signal. The target memory address is constructed from the

instruction’s encoded address fields, ensuring correct mapping within the array memory space.

For R-Type instructions, the decoder configures the ALU operation code using the instruction’s func-

tion fields. It selects the appropriate operand sources and enables all PEs and register write-back.

In the case of inter-PE communication (NEWS-Type instructions), the operation is similar to the one

specified by the R-Type instruction with the addition of a 2-bit combination sent to the NEWS mux

to set the communication direction.

### 3.4.3 Instruction Set Architecture

The control architecture of the processor consists of four 20-bit instruction classes shown in Fig-

ure 6. Each instruction is uniquely identified by a 2 bit opcode located at the LSB positions of the

instruction word. There are two primary I/O based instructions which facilitate memory-mapped

addressing for individual PEs (loads and stores) and 2 for arithmetic and movement operations (R-

Type and NEWS).

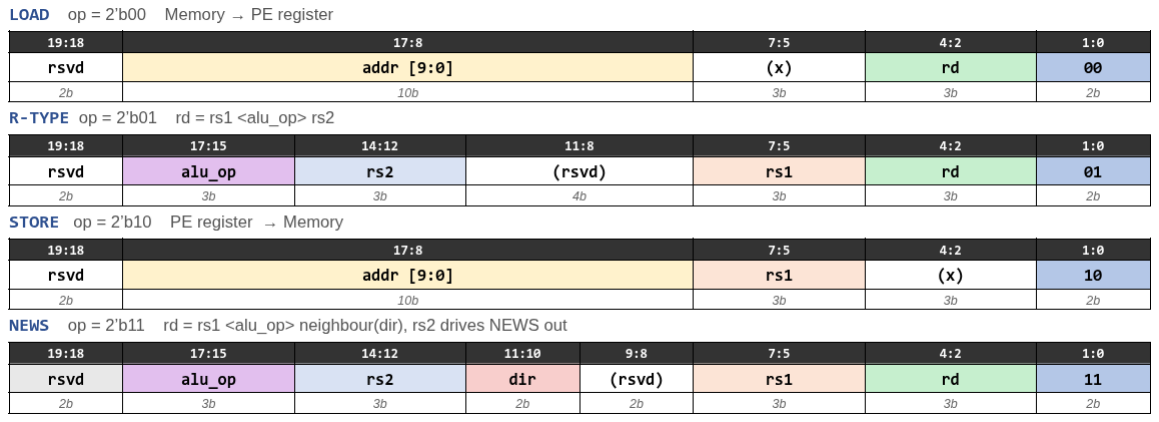
[picture p20: figure]

Fig. 6. Instruction Types for the Array Processor

Each I/O instruction encodes the memory address (addr) and either the source (rs1) or destination

(rd) register of the PE. Both load and store operations complete in 18 clock cycles. The instruction

types are designed so that the bit field encodings remain in the same bit position for different in-

structions, simplifying the decoding logic.

In addition to memory operations, the architecture employs R-Type instructions to perform arith-

metic and logical computations via the ALU using two register values as input operands. These op-

erations are governed by a 3 bit identifier (alu_op), allowing for the operations ADD, AND, OR, XOR,

SUB, GETMSB and SRA to be implemented. All R-Type operations execute in 17 cycles correspond-

ing to the word length.

The NEWS-Type instruction is used specifically for 2D array processing by leveraging 4-way connec-

tions between a PE and its neighbours. It contains a 3 bit ALU operation code (alu_op) with two

source operands (rs1 and rs2) and a destination register (rd). A direction specific field (dir) takes in

2 bits, allowing the 4 cardinal directions to be specified. Even with the data exchange and ALU op-

eration, the instruction is completed in 17 cycles.

Table 3 summarises the instruction set architecture (ISA) and its corresponding C-level representa-

tions.

Table 3. Instruction Set Summary

Instruction | Type | Description
vload(rd, imm) | LOAD | Load from memory into rd
vstore(rs1, imm) | STORE | Store rs1 to memory address
vadd(rd, rs1, rs2) | R-Type | rd = rs1 + rs2
vsub(rd, rs1, rs2) | R-Type | rd = rs1 - rs2
vxor(rd, rs1, rs2) | R-Type | rd = rs1 ^ rs2
vorr(rd, rs1, rs2) | R-Type | rd = rs1 | rs2
vandd(rd, rs1, rs2) | R-Type | rd = rs1 & rs2
getmsb(rd, rs1) | R-Type | rd = msb(r1)
vsra(rd, rs1, shamt) | R-Type | rd = rs1 >> shamt
mv{N|E|W|S}add(rd, rs1, rs2) | NEWS | rd = neighbour(dir) +
| | rs2
mv{N|E|W|S}sub(rd, rs1, rs2) | NEWS | rd = neighbour(dir) -
| | rs2

### 3.5 System Design

Additional supporting components, as shown in Figure 7, are required alongside the array proces-

sor in order to simplify system programming and enable more complex operations to be performed.

The PYNQ-Z2 development board integrates an ARM Cortex-A9 processor, which is used to com-

municate instructions to the array processor. Communication between the ARM processor, block

RAM (BRAM), and the array processor is implemented using AXI-Lite interfaces, enabling memory-

mapped communication. This approach simplifies system integration and allows additional periph-

erals to be integrated into the system architecture with minimal modification.

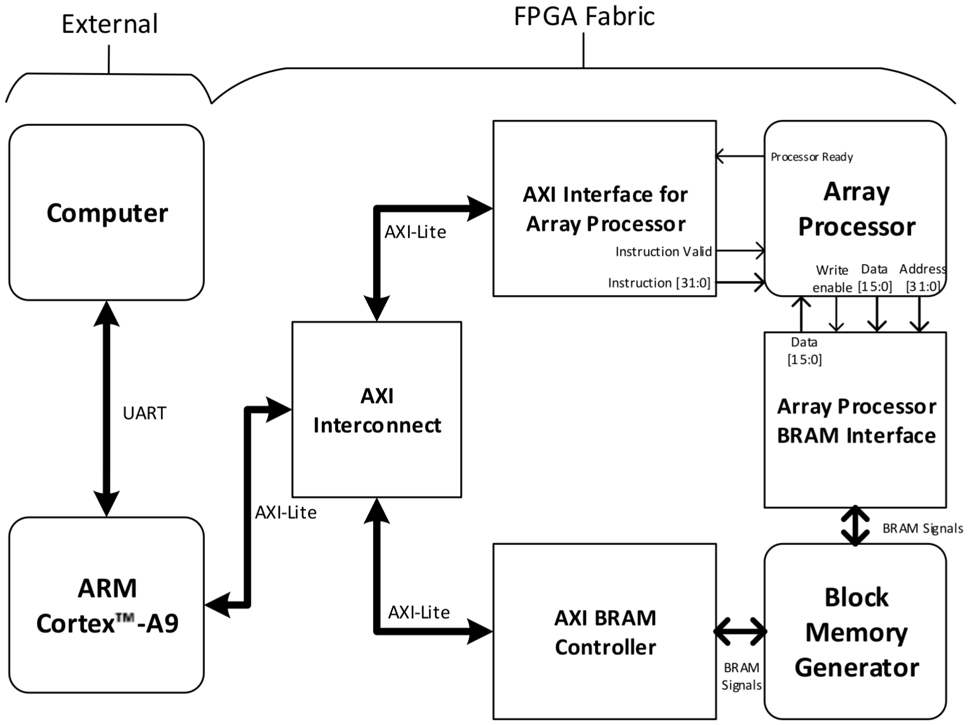
[picture p21: figure]

Fig. 7. System implementation for array processor. Important data, control and bus interface signals are presented. Bold arrows represent buses consisting of multiple signal types

The ARM processor also provides the primary system clock for the design, while a processor system

reset module generates the required reset signals for the different hardware components. Com-

munication between the ARM processor and the host computer is performed via a UART interface,

enabling the transmission of instructions and system control from the external machine.

In addition to the processor subsystem, dedicated AXI and BRAM interfaces have been designed to

enable communication between the processor and the on-chip memory. The AXI interface is used

for the transmission of control signals between the processor and the array processor. For hand-

shaking a processor-ready signal indicates that the current instruction has completed execution

and, an instruction-valid signal is used to indicate the availability of a new instruction. An instruc-

tion is transmitted only when the ready signal is asserted and the instruction-valid signal experi-

ences a rising edge, preventing repeating the same instruction execution.

The BRAM is configured as a true dual-port memory, allowing independent read and write operations to be performed simultaneously. The write enable (WEB) port is used to control write oper-

ations and to support different write widths when required. Read operations are performed when

the enable signal is set to logic 0, while write operations occur when the signal is asserted to logic

high. The BRAM interface accepts a 32-bit address, enabling access to a large memory space for

instruction and data storage.

### 3.6 Kernel Computation

### 3.6.1 Movement-Based Convolution on the Array

A 2D convolution with a 3x3 kernel can be expressed as a weighted sum of a pixel and its eight im-

mediate neighbours. The full derivation from the continuous convolution integral through to the

expanded discrete form is given in Appendix G. From this expansion, each kernel element ki,j at

offset (i, j) from the centre corresponds to a vertical shift y → y − i, a horizontal shift x →

x − j, and a multiplication by the kernel weight (adopting the coordinate convention y-increases-

downward, so a north shift is y → y − 1). This structure maps onto the NEWS interconnect: hori-

zontal shifts are realised as east/west movements between PEs, vertical shifts as north/south move-

ments, and diagonals as compositions of the two (e.g. north-east is a north move followed by an

east move).

Applying this formulation to the Sobel operator removes the need for a hardware multiplier en-

tirely. The horizontal and vertical Sobel kernels contain only the weights {−2, −1, 0, 1, 2}, and the

weighting factor of two can be produced by repeated summation of shifted images rather than by

multiplication. The detailed derivation of the Sobel kernels in this movement-based form is given in

Appendix H, and reduces the horizontal gradient to the three-instruction sequence shown in Listing

1, with the vertical gradient following the symmetric form in Listing 2.

Listing 1. Gx Kernel
1 | B = I + I(north)
2 | C = B + B(south)
3 | D = C(east) - C(west)

Listing 2. Gy Kernel
1 | B = I + I(east)
2 | C = B + B(west)
3 | D = C(north) - C(south)

### 3.6.2 Algorithm for Sobel Edge Detection on 8-bit Greyscale Images

Using the derivation from Section 3.6.1, the horizontal Sobel gradient is obtained by first comput-

ing the vertically weighted column sum given in Equation (H.8). The horizontal gradient is then

formed by subtracting the west column from the east column as described in Equation (H.9).

The vertical Sobel gradient is computed using the same weighting principle but with horizontal

shifts, corresponding to the Gy kernel in Equation (H.1).

The gradient magnitude is then approximated using the sum of absolute gradient values

O(x, y) = |Gx(x, y)| + |Gy(x, y)| | (3.1)

This approximation avoids the computational cost of a square-root operation while still providing a

reliable estimate of edge strength.

Finally, the result is shifted right by three bits (division by 8) to ensure that the output value re-

mains within the 8-bit range (0–255), since the maximum value produced by the preceding oper-

ations is 2040.

As the algorithm relies only on neighbour shifts, additions, and subtractions, it maps efficiently to

the proposed array processor architecture and enables parallel edge detection across the image.

### 3.7 MNIST Digit Classification

The following sections describe the CNN model architecture and its implementation using the array

processor’s instruction set to classify MNIST digits.

### 3.7.1 CNN Model Architecture

In this work, images from the MNIST dataset are rescaled from 28×28 to 16×16 pixels to align with

the dimensions of the array processor. A 16×16 configuration is preferred over 32×32, as it enables

efficient mapping without zero-padding, thereby avoiding unnecessary I/O overhead and underutil-

isation of processing elements that would arise when mapping a 28×28 input onto a larger array.

Each greyscale pixel is then directly mapped to a corresponding processing element. The model was trained on the rescaled 16×16 dataset with weights quantised to Q1.7 fixed-point format, achiev-

ing 95.2% accuracy on the MNIST test set.

The classification model used in this work is a shallow Convolutional Neural Network (CNN). The

network consists of a single convolutional layer with two output channels, followed by a max-pooling

and a fully connected classification layer. The convolutional layer used two 3x3 kernels that are ap-

plied across the 16x16 input image. The boundary 2 rows/columns produced by zero-padded con-

volution are discarded, yielding a 14×14 valid region used by the classifier.

Following the convolution stage, the Rectified Linear Unit (ReLU) activation function (as defined in

equation (3.2)) is applied after the convolution operation. This activation function was selected due

to its implementation simplicity for the array processor.

f(x) = max(0, x) | (3.2)

Here, x denotes the input to the activation function, and f(x) is the output after applying the ReLU

non-linearity.

Next, a 2x2 max-pooling operation is applied independently to each feature map shown in equa-

tion (3.3). This operation reduces the feature map size from 14x14 to 7x7, lowering the computa-

tional cost in subsequent processing stages.

yi,j = max (x2i,2j
, x2i+1,2j
, x2i,2j+1, x2i+1,2j+1) | (3.3)

In equation (3.3), xm,n represents the input value at row m and column n of the feature map, while

yi,j is the pooled output at row i and column j.

Following the pooling stage, the feature maps are flattened into a one-dimensional vector that

forms the input to the fully connected layer.This layer computes a weighted sum of this vector ac-

cording to equation (3.4), producing ten output activations corresponding to the ten digits 0 - 9.

The predicted number is determined by selecting the output neuron with the highest value.

yˆ = arg max
j∈{0,...,9}

(︄
bj +

N

∑︂⁻¹

i=0

wi,j · xi

)︄
(3.4)

Here, yˆ represents the index of the neuron with the maximum output activation, xi

is the i-th input vector, wij is the weight connecting input i to neuron j, bj

is the bias term of the j-th neuron, and

N is the total number of input features.

The network architecture was intentionally designed to be lightweight in order to demonstrate the

processor’s capability to implement a CNN with high power and area efficiency. Using only two

convolution channels significantly reduces the number of arithmetic operations and intermediate

feature maps, while still achieving accurate digit classification. The CNN model was trained on a PC

using the MNIST training dataset, and the resulting weights were extracted for inference.

### 3.8 Array Processor Implementation for MNIST Digit Classification

### 3.8.1 System Memory Organisation

A dual-port block RAM (BRAM) serves as the shared memory interface between the host ARM Cortex-

A9 and the array processor. The BRAM address space is partitioned into regions summarised in Ap-

pendix I Table 5.

The host loads the 16 x 16 image into BRAM at initialisation, and the array processor reads or writes this memory through vload/vstore instructions, each addressed by a 10-bit PE identifier corre-

sponding to a linearised row-major index.

### 3.8.2 Register Organisation

The image is loaded into r1 by writing the pixel data to BRAM addresses 0–255 and issuing a cor-

responding stream of vload instructions. The register file allocation used throughout inference is

shown in Appendix I Table 6.

### 3.8.3 Convolution Using Shift-and-Add Decomposition

As demonstrated by equation (G.4), each convolution requires the summation sequence of image

shifts multiplied with a weight.

Trained weights are interpreted as Q1.7 fixed-point fractions (i.e. w/128), so multiplication by a

weight w is realised by decomposing |w| into a sum of powers of two and accumulating arithmetic

right-shifts (vsra) of the operand. For a weight w = 89, for example, the decomposition 89 =

64 + 16 + 8 + 1 yields four vsra/vadd pairs with shift amounts 1, 3, 4, and 7 respectively. Negative

weights substitute vsub for vadd. This example is shown in Listing 3 using the instruction encod-

ings found in Table 3

A move to a cardinal neighbour is expressed as, for example, mvsouthadd(dst, r0, src), which shifts

src one step northward (i.e. each PE receives the value from its southern neighbour) by exploiting

the add-with-zero identity. Diagonal neighbours are reached by composing two orthogonal shifts.

Following each complete convolution, a rescaling right-shift of three positions reduces the accumu-

lator magnitude to ensure the values do not overflow before being passed to the activation func-

tion.

Listing 3. Example of multiplication by the (0,0) weight
1 | //position(0 ,0) weight=89
2 | issue( mvsouthadd (3, 0, 1)); // r3 = north(r1) + r0 = move
3 | issue( mveastadd (3, 0, 3)); | // r3 = west(r3) = NW
4 | issue(vsra (4, 3, 7)); issue(vadd (2, 2, 4));
5 | issue(vsra (4, 3, 4)); issue(vadd (2, 2, 4));
6 | issue(vsra (4, 3, 3)); issue(vadd (2, 2, 4));
7 | issue(vsra (4, 3, 1)); issue(vadd (2, 2, 4));

### 3.8.4 ReLU Activation

ReLU is implemented entirely with bitwise logic, avoiding any conditional branch or comparison in-

struction. The sign bit (MSB) of the accumulator is extracted and replicated across all 16 bits. A bit-

wise XOR with the all-ones mask then produces the inverse, yielding an all-zeros word when the ac-

cumulator is negative and an all-ones word when it is non-negative. An AND of this mask with the

accumulator clamps negative values to zero while leaving positive values unchanged:

Listing 4. ReLU activation
1 | getmsb (3, 2); | // r3 = sign(r2)
2 | vxor (3, 3, 7); | // r3 = ~sign(r2)
3 | vandd (2, 2, 3); | // r2 = r2 & r3

### 3.8.5 Max Pooling

A 2x2 stride-2 max-pooling operation is performed with two rounds. The source feature map is first

copied into r1, each PE then computes the maximum of itself and its eastern neighbour, followed by the maximum of the updated value and its southern neighbour. Each pairwise maximum is com-

puted without a comparator instruction by using the sign of the difference:

Listing 5. Max Computation for Eastern Neighbour
1 | mvwestadd (2, 0, 1); | // r2 = east of r1
2 | vsub (3, 1, 2); | // r3 = self - east
3 | getmsb (4, 3); | // r4 = sign(self -east)
4 | vxor (5, 4, 7); | // r5 = ~sign
5 | vandd (3, 1, 5); | // r3 = self where self >= east
6 | vandd (5, 2, 4); | // r5 = east where east > self
7 | vorr (1, 3, 5); | // r1 = max(self , east)

After both rounds, r1 holds the 2x2 maximum at every PE. Stride-2 sampling is performed storing

only the odd-indexed PE positions (rows and columns 1, 3, 5, 7, 9, 11, 13), extracting 49 pooled val-

ues per channel and writing them to their designated BRAM region. The two-channel pool there-

fore produces a 98-element feature vector.

### 3.8.6 Fully Connected Layer

The fully connected layer is executed on the host processor rather than the array processor, due

to the lack of multiply-accumulate units. The host reads the 98 pooled values from BRAM and com-

putes a dot product with each of the ten sets of FC weights, accumulating into a 32-bit integer score.

A bias term is added for each class, and the class index achieving the maximum score is returned as

the predicted digit as demonstrated by equation (3.4).

### 3.9 Summary

This chapter has presented the processor (for both the data-path and control), instruction set, sys-

tem integration, and workload implementation for the array. The processor is built around a NEWS-

connected grid of bit-serial PEs controlled by a unified hardware based control FSM and a 20-bit

ISA, with LUTRAM-mapped register storage and AXI-Lite system integration. Two image-processing

workloads, Sobel edge detection and a shallow MNIST CNN, demonstrate how the ISA can be used

to run different workloads.

## 4 Results and Discussion

### 4.1 Introduction

This chapter evaluates the bit-serial SIMD array implemented in Chapter 3 on a PYNQ-Z2 (Xilinx

XC7Z020) platform. The analysis has three aims: to characterise the baseline performance of the

design at a fixed configuration, to quantify how performance and resource cost scale with the three

principal design parameters (array size, data-path width, and register-file depth), and to identify

the bottlenecks that constrain efficiency.

Two workloads are used to quantify the processor: a 3 x 3 Sobel edge-detection filter, executed

on the 32 x 32 (1024-PE) configuration, and a shallow MNIST digit classifier, executed on the 16 x

16 (256-PE) configuration. The workloads are described in Sections 3.6 and 3.7 respectively. They

were chosen as together they exercise every instruction class supported by the ISA and contain dif-

ferent data-movement patterns. The 16 x 16 configuration was used for the classifier rather than

the maximum 32 x 32 because downscaling the MNIST input from 28 x 28 to 16 x 16 yields a 1:1

pixel-to-PE mapping without zero-padding overhead, while preserving sufficient spatial resolution

for digit classification.

Section 4.2 describes the measurement infrastructure and workload. Section 4.3 presents the base-

line characterisation in the default configuration (32 x 32 array, 16-bit datapath, register depth of

8). Section 4.4 examines how area, power, and throughput are affected by scaling the number of

PEs. Section 4.5 shows the results from running the two workloads and their execution times. Sec-

tion 4.6 compares against prior bit-serial SIMD designs, and Section 4.7 discusses the results, bot-

tlenecks, and identifies improvements.

### 4.2 Experimental Methodology

### 4.2.1 Simulation and Measurement Infrastructure

All functional and cycle-count results were obtained from a SystemVerilog simulation test-bench

found in /Individual_Project/sim within the Array Processor repository, as referenced in Appendix F.

The repository README documents the purpose of each test-bench.

To extract cycle counts per FSM state, an external module was introduced. It operates by tapping

the current state signal and storing the number of clock cycle for each state. The per-instruction

cycles-per-instruction (CPI) was obtained by counting cycles between successive rising edges of the

control ready signal and categorising them based on the opcode field.

Resource utilisation, achievable clock frequency (Fmax), and post-route power were obtained from

Vivado utilisation report, timing summary, and power reports respectively. Power was estimated

post-implementation using Vivado’s vectorless analysis, which infers switching activity from default

toggle-rate assumptions. Device static power is reported as the top-level leakage figure, which is an

intrinsic property of the XC7Z020 at the estimated junction temperature.

### 4.3 Baseline Characterisation

All baseline results in this section are taken at the default configuration (32 x 32 array, data width

of 16, and a register depth of 8. The number classification workload, characterised on the 16×16

configuration, is reported separately where indicated.

### 4.3.1 Per-PE Utilisation

Without Vivado’s optimiser, each PE occupies 26 LUTs (18 logic LUTs and 8 LUTRAMs) when measured by applying the keep_hierarchy = "yes" attribute to the PE module. This attribute pre-

vents the synthesiser from merging logic across module boundaries. This represents the true per-

PE cost before cross-boundary optimisation.

When keep_hierarchy = "no", each PE utilises fewer LUT and slices. Due to Vivado’s cross-boundary

optimisation, per-PE LUT usage varies across the array with some PEs occupying 4 slices (2 SLICEM

and 2 SLICEL) and some occupying 3 (2 SLICEM and 1 SLICEL). A test of a 16 x 16 grid of PEs revealed

that, 227 (88.7%) report 0 logic LUTs and 8 LUTRAMs, 28 (10.9%) report 2 logic LUTs and 8 LUTRAMs,

and one PE reports 1 logic LUT and 8 LUTRAMs, as the synthesiser merges combinational logic into

neighbouring cells where possible. What remains constant across all PEs are 8 RAMD64E distributed-

RAM cells implementing the register file, 4 MUXF7 wide-mux primitives building the register file’s

read path, and 1 flip-flop inferred for the carry register. In theory, up to 5184 PEs (72 × 72) could fit

on the FPGA based purely on LUT availability. However, the PE array size must be a power of two,

so the largest theoretically achievable configuration is 64 × 64. In practice, as shown in Section 4.4,

LUTRAM is the binding resource that limits scaling, reducing the maximum usable array to 32 x 32

PEs and occupying 47% of the available LUTRAM. Figure 8 shows the slices and the primitives inside

of them used to build each PE. The two SLICEMs and the top-right SLICEL are consistent throughout

all PEs while the top left SLICEL varies between PEs.

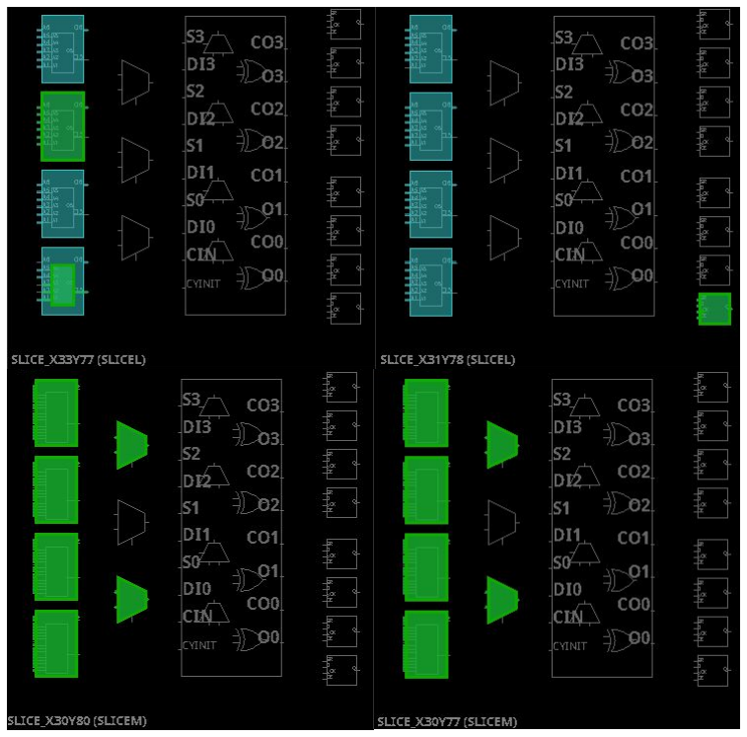
[picture p22: figure]

Fig. 8. Slice composition of a single PE. Top two slices are SLICEL, bottom two are SLICEM; PE resources are highlighted in green neighbouring PE resources in teal.

### 4.3.2 Cycles per Instruction and Cycle Breakdown by FSM State

The comparison of cycles per instruction are shown in Table 4.

Table 4. Theoretical vs Measured CPI by Instruction

Instruction | Theoretical CPI | Measured CPI
LOAD | 18 | 30
STORE | 18 | 30
R-Type (ADD/SRA/GETMSB) | 17 | 29
NEWS-Type | 17 | 29

The theoretical cycle counts are derived from the number of states associated with each instruc-

tion in the FSM (Figure 5). It can be observed that the measured CPI is consistently 12 cycles higher

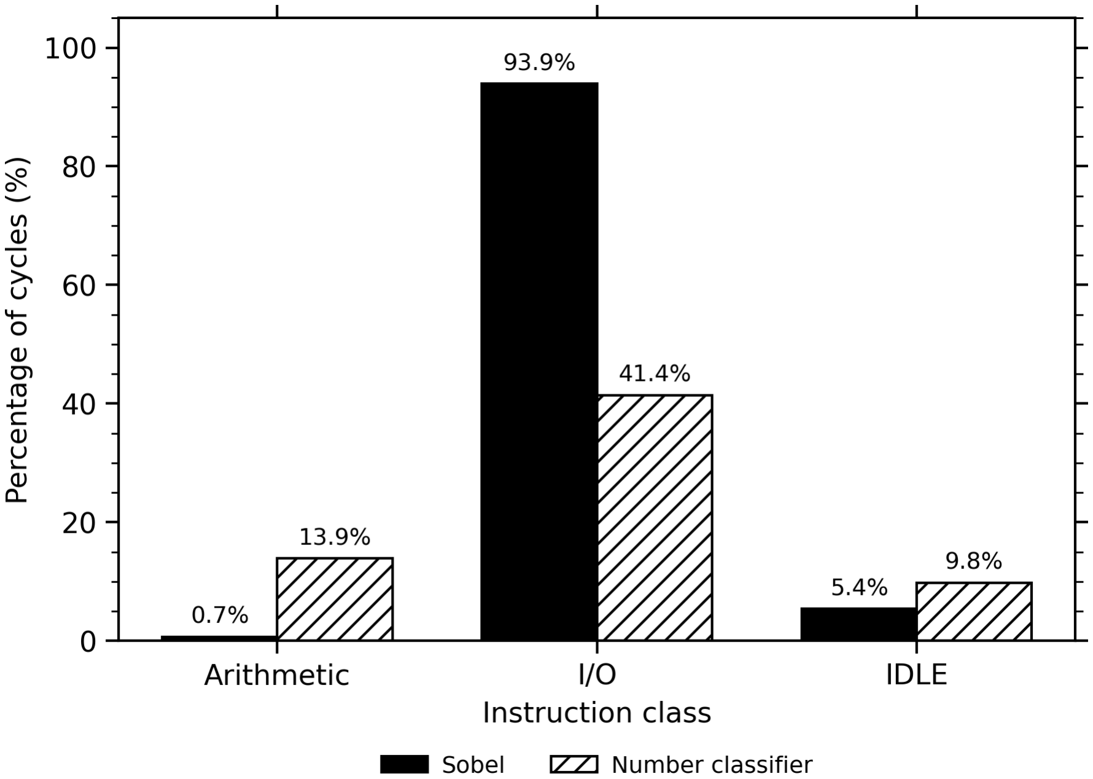
[picture p23: figure]

Fig. 9. Cycle distribution by FSM state for the Sobel and number-classification workloads. The Sobel filter is executed on the 32×32 (1024-PE) configuration; the classifier is executed on the 16×16 (256-PE) configuration. Arithmetic combines R-type and NEWS-type instructions; I/O combines load and store; IDLE counts cycles in which no instruction is executing.

than the theoretical values. This discrepancy arises from the overhead introduced by the AXI-Lite

interface when transmitting instructions, which adds a fixed latency to each operation.

Figure 9, illustrates the normalised cycle distribution across each FSM for both the Sobel and num-

ber classification workloads. In this case, arithmetic includes both R-Type and NEWS-Type instruc-

tions, I/O includes load and store operations, and IDLE refers to periods when the processor is not

executing any instructions. Note that the MNIST cycle distribution is measured on the 16×16 con-

figuration, while Sobel is measured on 32×32.

The cycles are expected to be dominated by I/O instruction types, since each pixel in a 32×32 image

requires both a load and a store operation. (1024 loads and stores for the 32×32 Sobel image, and

256 for the 16×16 MNIST image). Hence, most instructions will be allocated to memory while only

a few are arithmetic based ones. This memory bottleneck is a direct consequence of the single-

word PISO/SIPO interface, and is revisited in Section 4.7.1.

This effect is shown more clearly when comparing the Sobel workload against the simple image

classifier. In the classifier algorithm, there are proportionally more arithmetic instructions for the

same number of loads and stores, which is reflected in the shift from 0.7% arithmetic cycles in So-

bel to 13.9% for the number classifier. Correspondingly, the memory share drops from 93.9% to

41.4%, indicating that the classifier is significantly more compute-bound than the Sobel edge detector. The IDLE share also grows slightly, from 5.4% in Sobel to 9.8% for the number classifier. This

is due to the increased per-instruction handshaking overhead incurred by a longer instruction stream.

### 4.3.3 Throughput

The array’s peak computational throughput is reported in bit-serial giga-operations per second (GOPS).

Each of the 1024 PEs produces one bit-level operation per clock cycle during arithmetic execution

so the peak bit-operation rate of the array is given by

OPSbit = NPE × fclk, | (4.1)

where OPSbit is the bit-level operation rate, NPE is the number of PEs (1024), and fclk is the maxi-

mum clock frequency (71 MHz). This yields a peak throughput of approximately 72.7 GOPS.

However, this represents the theoretical maximum bit-level activity and does not account for instruction-

level execution overhead. Each instruction requires multiple clock cycles to complete, meaning that

new operations are only issued once per instruction cycle.

The effective word-level throughput can therefore be expressed as

OPSef f =

NPE × fclk
CPI

=

1024 × 71 × 10⁶
30
≈ 2.42 GOPS. | (4.2)

where OPSef f represents the effective instruction-level operation rate excluding the AXI handshake,

and CPI is the average cycles per instruction.

The max operating frequency is bounded by a critical path originating at the state register in the

control unit and traversing to the MSB of the SIPO output register. The total delay along this route

is 13.70 ns leaving 58 ps of positive slack. The delay is dominated by routing (≈82%) rather than

logic (≈18%), reflecting the spatial spread of the PE array across the fabric.

### 4.4 Array Size Sweeps

This section goes through how the metrics of the array are affected by scaling the array size from a

size of 2 x 2 (4 PEs) to 32 x 32 (1024 PEs).

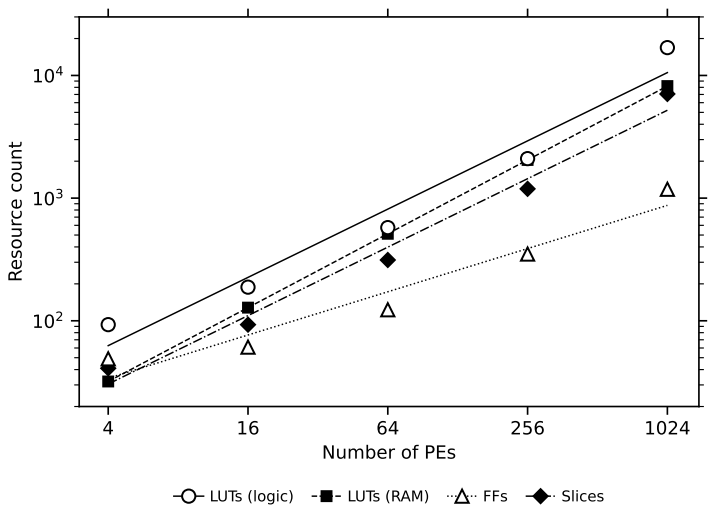
[picture p24: figure]
Number of PEs; Resource count; LUTs (logic); LUTs (RAM); FFs; Slices

Fig. 10. FPGA resource utilisation as a function of array size. Logic LUTs, LUTRAMs, flip-flops, and slices are reported for five PE configurations (4, 16, 64, 256, 1024). Lines are linear regressions in log–log space.

Figure 10 shows the resource scaling across the five configurations. The trendline for LUTRAM count

is linear line of unit slope, indicating linear scaling with PE count. This is the expected behaviour as

the distributed register file in each PE does not interact across PEs and cannot be merged by the

synthesiser. The slope for the flip-flop count is the lowest as each PE only contains 1 FF. On the

other hand, Logic LUTs and slices scale faster than the other resources, particularly at larger array

sizes. Between 256 and 1024 PEs, the LUT count grows by roughly 8× for a 4× increase in PE count.

This growth is driven by the higher amount of LUTs per slice and the OR-reduction tree, whose fan-

out forces the placer to insert buffers. At 1024 PEs the design consumes 31.7% of the XC7Z020’s

logic LUTs and 47.1% of its LUTRAM, making LUTRAM the binding resource.

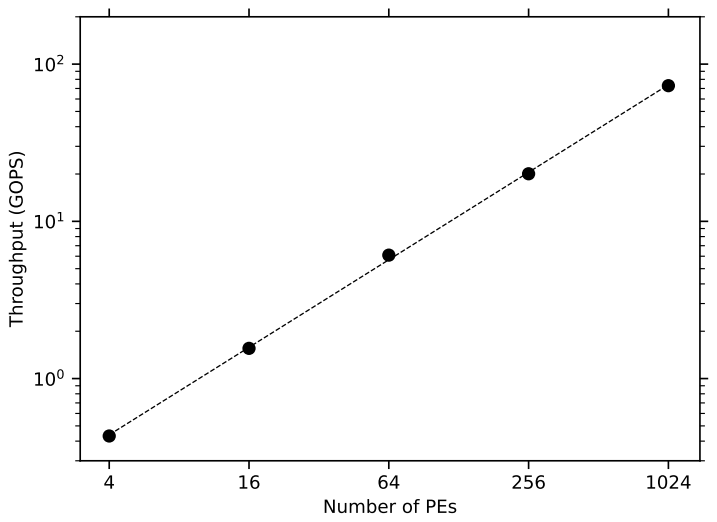
[picture p25: figure]
Number of PEs; Throughput (GOPS)

Fig. 11. Theoretical peak bit-level throughput as a function of array size. The dashed line is a linear regression in log–log space

Throughput, shown in Figure 11, is reported as the theoretical bit-level peak GOPS = Fmax · NPE,

with each PE performing one bit-serial operation per cycle (note this is distinct from word-level

throughput, which is lower based on the CPI.) The trendline has a gradient of 0.925, indicating a

slightly sub-linear scaling. Throughput rises from 0.43 GOPS at 4 PEs to 72.92 GOPS at 1024 PEs;

since each step increases the PE count by 4x, ideal scaling would yield a 4x speed-up per step, while

the measured per-step speed-ups are 3.61x, 3.92x, 3.29x, and 3.63x. The shortfall is due to the

degradation of the maximum clock frequency. Fmax falls from 107.8 MHz at 4 PEs to 71.2 MHz at

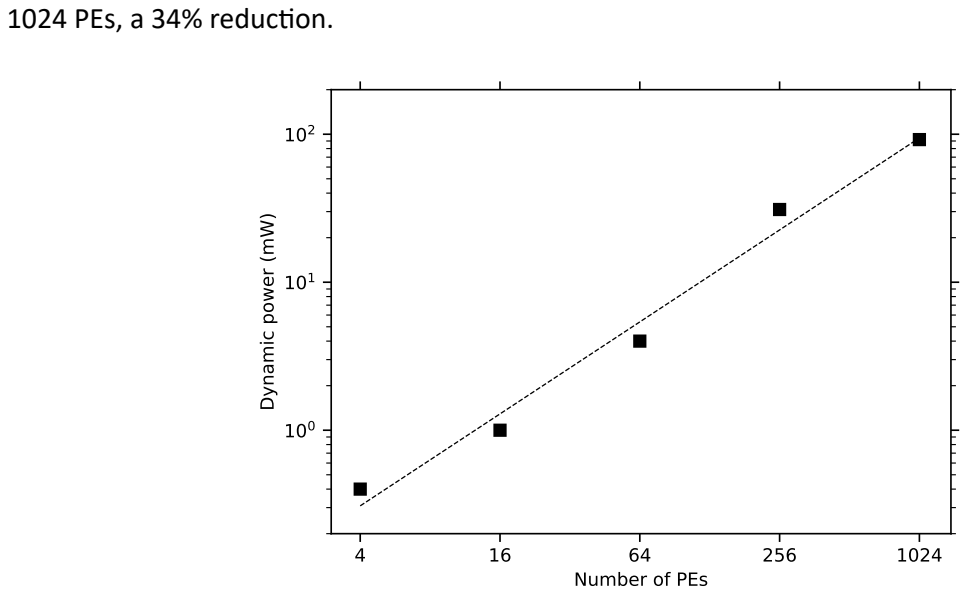
[picture p26: figure]
1024 PEs, a 34% reduction.; Number of PEs; Dynamic power (mW)

Fig. 12. Dynamic power consumption as a function of array size. Power is reported for the array and control unit only, measured using a vectorless method. The dashed line is a linear regression in log–log space

Figure 12 shows dynamic power of the processor (control and array) rising from 0.4 mW at 4 PEs

to 92 mW at 1024 PEs. Similar to metrics described in the sections above, switching activity scales

proportionally to PE count. Combining word-level throughput and power gives a peak energy ef-

ficiency of 0.0507 GOPS/mW at 16 PEs which degrades to 0.0264 GOPS/mW at 1024 PEs. This re-

duction in energy is due to the effects of sub-linear throughput scaling and the routing and fan-out

overhead as mentioned in previous sections. Hence, for workloads prioritising energy efficiency

over raw throughput, a configuration of 64-256 PEs offers a better operating point than the maxi-

mum array.

### 4.5 Resultant Images

Figure 13 shows the processor implementing Sobel Edge detection. Overall, the algorithm requires

4.28 µs to complete at a frequency of 71 MHz. However, if I/O instructions are included, the total

time for the program to complete is 870 µs

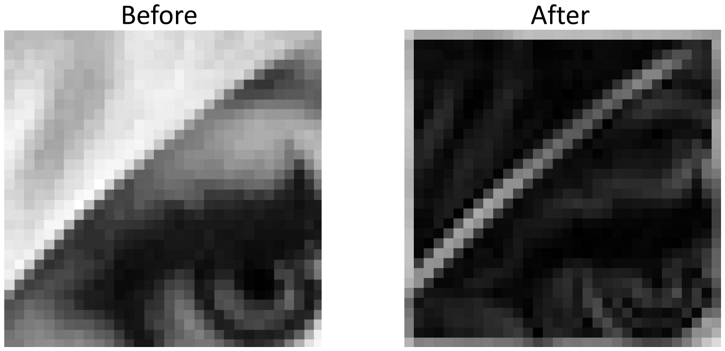
[picture p27: figure]

Fig. 13. Sobel edge detection on a 32x32 picture of an eye. Input shown on the left. Result shown on the right

Figure 14 shows the processor running a simple CNN on the digit eight (shown in the left). The re-

sults (shown on the figure to the right) displays the calculated weights for each digit, selecting the

highest one to be the predicted digit. The algorithm requires 109 µs to complete at a frequency

of 71 MHz. However, if I/O instructions are included, the total time for the program to complete is

975 µs

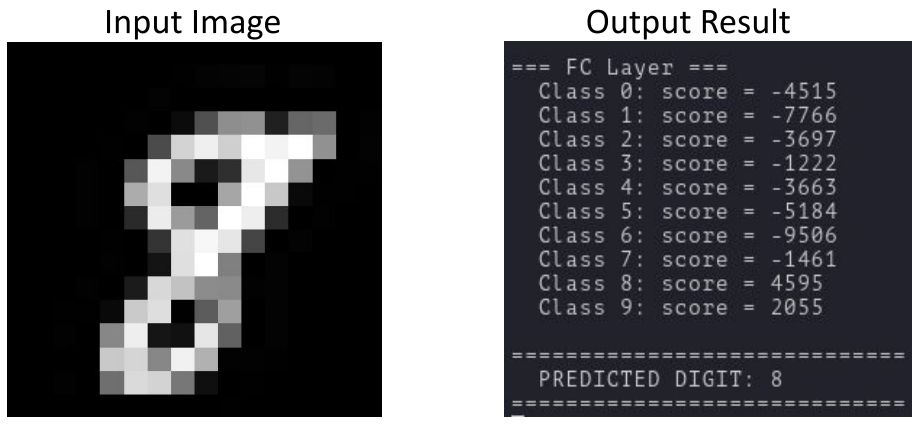
[picture p28: figure]

Fig. 14. Number classification for the 16x16 digit eight. Input shown on the left. Result shown on the right

### 4.6 Comparison Against Prior Bit-Serial SIMD Designs

Direct comparison against the architectures surveyed in Chapter 2 is bounded by differences in fab-

rication target, arithmetic precision, and reported metrics. The comparisons to be made in this sec-

tion will be those that utilise a bit-serial SIMD design.

The closest direct comparator is the bit-serial array of Walsh and Dudek [15], which targets a older

Virtex-5 FPGA with bit-serial PEs with NEWS connectivity. The two designs achieve comparable

per-PE footprints (3 - 4 slices versus 4), but Walsh’s reaches a substantially higher operating fre-

quency (150 MHz vs 71 MHz). Walsh’s design does not include AXI-Lite host integration or the sys-

tem wrapper used here, which adds per-instruction latency. The present work extends Walsh’s de-

sign in two ways: shift-and-add convolution support in the ISA, enabling CNN workloads beyond

Walsh’s boolean and integer arithmetic, and integration into a complete ARM-host system.

SPAR-2 [16] and IMAGine [17] take a different approach, pairing bit-serial ALUs with distributed

BRAMs in a processing-in-memory. This avoids the OR-tree bottleneck identified in Section 4.7.1

and reaches frequencies up to 737 MHz, more than 10x the 71 MHz achieved here. However, it

trades the pixel-to-PE locality that makes the present design efficient on Sobel and CNN convolu-

tions. SCAMP-5 [14] retains the strongest energy efficiency at 0.535 GOPS/mW as it uses mixed-

signal ASIC fabrication, against the 0.0507 GOPS/mW peak measured here (Section 4.4).

### 4.7 Discussion

### 4.7.1 Bottleneck Analysis

Overall, the results exposes three bottlenecks:

It is evident that the dominant limiting factor for performance is the single word memory inter-

face. Every word that goes into and out of the array has to be serialised through PISO/SIPO regis-

ters across the data width. This is why Sobel spends 93.9% of its cycles in memory states while the

number classifier, with its higher arithmetic intensity, drops to 41.4% (Table 9).

The second bottleneck is the OR-reduction output tree, whose depth grows as log2

(NPE). The mea-

sured Fmax reduction from 107.8 MHz to 71.2 MHz from 4 to 1024 PEs tracks this growth directly.

Furthermore, the sharp rise in logic LUTs between 256 and 1024 PEs reflects the placer replicating

drivers and inserting buffers on the high-fan-out nets feeding the tree.

The third bottleneck is the Axi-Lite protocol latency, responsible for the uniform +12-cycle gap be-

tween theoretical and measured CPI (Table 4). As this cost occurs for every instruction, it grows as

the array grows. The time spent in the IDLE state rising from 5.4% to 9.8% between Sobel and the

number classifier demonstrates that a longer instruction stream pays this tax more often.

### 4.7.2 Implications for Design Improvements

The most effective change is to widen the memory interface, replacing the single PISO with a per-

column bank so that a full row can be loaded in a number of cycles equal to the data width rather

than scaling with both the number of columns and the data width. For the 32x32 array this reduces

the per-image load/store cost by a factor of 32 and would bring Sobel’s memory share down to-

ward the 41.4% figure seen in the number classifier case. Since LUTRAM rather than logic LUTs is

the binding resource, and shift registers map efficiently to SRLs on the XC7Z020, this widening is af-

fordable on the existing device.

The second improvement is to pipeline the OR-reduction tree. Inserting a register stage every few

levels would decouple Fmax from array size at the cost of one added cycle per stage on the STORE

path. This is negligible relative to the data width cycle serial transfer it feeds. This would remove

the Fmax cliff observed beyond 256 PEs and restore near-linear throughput scaling.

The third improvement targets the instruction delivery path in the system level design. An instruc-

tion buffer placed between the ARM core and the processor would remove its lockstep. The buffer

will be filled infrequently by the host and drained autonomously by the FSM, eliminating the per-

instruction AXI-Lite handshake.

### 4.7.3 Threats to Validity

Fmax was obtained under Vivado’s default implementation strategy, so the 34% degradation be-

tween 4 and 1024 PEs reflects tool effort rather than a silicon limit, and directed optimisation could

likely recover part of it. Post-route power was measured using the default switching activity set by

Vivado, so the reported GOPS/mW figures should be treated as indicative rather than measured

values tied to a particular workload. Finally, kernels with intermediate intensity or unusual NEWS

traffic patterns may show cycle distributions not captured in Figure 9 where only Sobel and num-

ber classification workloads were employed. The cross-workload comparisons in Section 4.3.2 are normalised per workload to remain meaningful however, running both workloads on a single con-

figuration would simplify direct comparison.

## 5 Project Management

The project was structured around a Project Plan and Gantt chart (Appendix B) made before any

work was started, defining the objectives and milestones to be completed. The Gantt chart was

used as a dynamic tracker rather than something static: it was reviewed before supervisor meet-

ings and when large changes to the project were required, providing a clear visual of completed

work against planned work and helping both the author and his supervisor decide the scope and

direction for each meeting.

In the first semester, job interviews occurred at short notice, mitigated by front-loading tasks into

earlier weeks to leave slack for later. Learning from prior projects, more work was allocated to the

design stages to reduce bugs during implementation; the literature review and design overran the

allocated two weeks, and a compromise was made to carry these out in parallel with prototyping

simpler RTL modules. A laptop failure later caused loss of data and applications, requiring working

hours to be extended into the Easter break.

Risks were tracked in the Risk Register (Appendix D), which compared each risk against its likeli-

hood, impact, and mitigation strategy, with entries identified by analysing mistakes from previous

projects. Key entries included tool-chain and data loss (mitigated through version control) and de-

lays from external activities (mitigated by parallel task execution). The Health & Safety Risk Assess-

ment (Appendix C) addressed risks to the author from prolonged desk-based work and the electri-

cal safety considerations of FPGA bench use.

Self-directed learning is documented in the CPD Log (Appendix E) and played an important part in

the project. Competence in SystemVerilog, bit-serial arithmetic, and Vivado synthesis was devel-

oped independently through textbooks, IEEE papers, and targeted online courses. Each significant

new skill was logged with its source, application, and a short reflection on how it influenced subse-

quent design choices, providing a traceable link between learning activity and project outcomes.

Initiative is most clearly evidenced by the response to finishing the Sobel edge-detection demon-

stration ahead of schedule. Rather than announcing the project was completed, the possibility of

extending the instruction set to support image-classification inference on the array, alongside future novel ideas, was proposed to the supervisor with a view to potential future publication. This

required re-scoping the remaining Gantt entries, updating the Risk Register with new technical

risks, and committing to additional independent study.

## 6 Conclusions and Future Work

This section presents the conclusions drawn from researching and designing this array processor

and the improvements that can be taken to address its limitations.

### 6.1 Conclusion

Of the five objectives defined in Section 1.2, four were met in full and one was met partially. Against

Objective 1, a parametrised bit-serial PE was designed and verified, occupying 3 to 4 slices per PE

with a constant 8 LUTRAMs and 1 carry flip-flop, a per-PE footprint comparable to the four-slice

cost reported by Walsh and Dudek [15]. Against Objective 2, each PE was replicated into a NEWS-

connected array, demonstrating that scaling from 4 to 1024 PEs on the XC7Z020 was possible, with

the maximum 32×32 configuration consuming 31.7% of the available logic LUTs and 47.1% of LU-

TRAM. Against Objective 3, a hardware control unit and 20-bit ISA covers all four instruction classes

with reliable handshaking communication between the ARM core and the processor. Against Ob-

jective 4, the array was integrated with an ARM Cortex-A9 over AXI-Lite and a true-dual-port BRAM,

and against Objective 5, both Sobel edge detection at 32×32 and MNIST classification at 16×16 pro-

duced correct output. It is worth mentioning the caveat associated with the MNIST workload here:

the convolution, ReLU, and max-pooling stages execute on the array, but the final fully connected

layer runs on the ARM host because the ISA trades multiply-accumulate support for area efficiency

and simplicity. The classifier is therefore a hybrid between the host and acceleration rather than a

fully on-array CNN.

Against the three evaluation criteria, the picture is mixed. Area efficiency was the most successful

criteria, with each PE taking up comparable area with other bit-serial array FPGA implementations.

Furthermore, the full 1024-PE array fits within the target device alongside with its supporting in-

frastructure. Performance scales with PE count, from 0.43 GOPS at 4 PEs to 72.92 GOPS at 1024

PEs at 71.2 MHz, but sub-linearly with a 34% Fmax degradation across the sweep; the headline fig-

ure is also a theoretical peak, with effective instruction-level throughput at 2.42 GOPS and Sobel spending 93.9% of cycles in memory states. Power efficiency peaks at 0.0507 GOPS/mW (16 PEs)

and settles to 0.0264 GOPS/mW at 1024 PEs.

### 6.2 Future Work

From an architectural standpoint, the current design employs a two-dimensional mesh intercon-

nect which, while area-efficient, incurs significant latency penalties for non-local data movement.

Examples of this include the stride two calculations after the first max pooling layer. Extending the

interconnect to support a richer topology, such as a hypercube or a hierarchical mesh similar to

that employed in the CM-2, would reduce worst-case hop counts and improve the performance of

operations that require broader spatial context.

The bit-serial datapath, while central to the area efficiency of the architecture, imposes a funda-

mental limit on per-operation latency. The next steps for future work would be to investigate a con-

figurable bit-width mode, in which groups of PEs could be dynamically reconfigured to operate in

a bit-parallel fashion for latency-critical operations and revert to bit-serial operation for bulk work-

loads. A mode for variable precision further allows for a higher throughput

Finally, integration with on-chip or near-sensor memory, in the spirit of the SCAMP-5 pixel proces-

sor array, represents an attractive long-term direction. By co-locating sensing, memory, and com-

putation, the memory bandwidth bottleneck that constrains many edge-intelligent systems may be

substantially reduced. Migrating the design from its current FPGA prototype to an ASIC implemen-

tation would also permit a more accurate assessment of its power and area efficiency and would

enable direct comparison with the historical and modern arrays reviewed in this report.

## References

[1] M. J. Flynn, “Very high-speed computing systems,” Proceedings of the IEEE, vol. 54, no. 12,

pp. 1901–1909, 1966 (cited on p. 14).

[2] M. J. Flynn, “Some computer organizations and their effectiveness,” IEEE Transactions on Computers, vol. C-21, no. 9, pp. 948–960, 1972. [Online]. Available: https://ieeexplore.
ieee.org/stamp/stamp.jsp?tp=%5C&arnumber=5009071 (https://ieeexplore.ieee.org/stamp/stamp.jsp?tp=%5C&arnumber=5009071) (cited on p. 14).

[3] K. E. Batcher, “Architecture of a massively parallel processor,” in Proceedings of the 7th An-

nual Symposium on Computer Architecture (ISCA ’80), 1980, pp. 168–173 (cited on p. 15).

[4] W. F. Wong and K. T. Lua, “A preliminary evaluation of a massively parallel processor: GAPP,” Microprocessing and Microprogramming, vol. 29, no. 1, pp. 53–62, 1990. DOI: 10 . 1016 /
0165-6074(90)90011-W (https://doi.org/10.1016/0165-6074(90)90011-W) (cited on p. 15).
[5] D. Parkinson, “The distributed array processor (dap),” Computer Physics Communications,

vol. 28, no. 4, pp. 325–336, 1982 (cited on p. 15).

[6] B. A. Kahle and W. D. Hillis, “The connection machine model CM-1 architecture,” IEEE Trans-

actions on Systems, Man and Cybernetics, vol. 19, no. 4, pp. 707–713, 1989 (cited on p. 15).

[7] Thinking Machines Corporation, “Connection machine model CM-2 technical summary,” Thinking Machines Corporation, Tech. Rep. HA87-4, 1987. [Online]. Available: https://bitsavers.

## org / pdf / thinkingMachines / CM2 / HA87 - 4 _ Connection _ Machine _ Model _ CM -

2_Technical_Summary_Apr1987.pdf (https://bitsavers.org/pdf/thinkingMachines/CM2/HA87-4_Connection_Machine_Model_CM-2_Technical_Summary_Apr1987.pdf) (cited on p. 15).

[8] S. Knowles, “Graphcore Colossus Mk2 IPU,” in IEEE Hot Chips 33 Symposium (HCS), IEEE, 2021

(cited on pp. 16, 17).

[9] R. Prabhakar et al., “SambaNova SN40L: Scaling the AI memory wall with dataflow and com-

position of experts,” arXiv preprint arXiv:2405.07518, 2024 (cited on p. 16).

[10] Graphcore Ltd., IPU processors: Colossus Mk2 GC200 architecture overview, https://www.

graphcore.ai/products/ipu, Accessed: 2026-04-16, 2020 (cited on p. 16).

[11] Cerebras Systems, Cerebras Wafer-Scale Engine 2 (WSE-2): Product brief, https : / / www .

cerebras.net/product-chip/, Accessed: 2026-04-16, 2021 (cited on pp. 16, 17).

[12] S. Lie, “Cerebras Architecture Deep Dive: First look inside the hardware/software co-design
for deep learning,” in IEEE Hot Chips 34 Symposium (HCS), IEEE, 2022. DOI: 10.1109/HCS55958.

2022.9895553 (https://doi.org/10.1109/HCS55958.2022.9895553) (cited on p. 16).

[13] R. Prabhakar et al., “16.4 SambaNova SN40L: A 5nm 2.5D dataflow accelerator with three

memory tiers for trillion parameter AI,” in IEEE International Solid-State Circuits Conference (ISSCC), 2025, pp. 296–298. DOI: 10.1109/ISSCC49661.2025.10904578 (https://doi.org/10.1109/ISSCC49661.2025.10904578) (cited on pp. 16,

17).

[14] S. J. Carey et al., “A 100,000 fps vision sensor with embedded 535 GOPS/W 256×256 SIMD

processor array,” in Proceedings of the IEEE Symposium on VLSI Circuits, Kyoto, Japan, 2013,

pp. C182–C183 (cited on pp. 16, 17, 42).

[15] D. Walsh and P. Dudek, “A compact FPGA implementation of a bit-serial SIMD cellular proces-

sor array,” in 13th International Workshop on Cellular Nanoscale Networks and their Applications (CNNA), IEEE, 2012, pp. 1–6. DOI: 10.1109/CNNA.2012.6331464 (https://doi.org/10.1109/CNNA.2012.6331464) (cited on pp. 17, 42,

45).

[16] S. Basalama et al., “SPAR-2: A SIMD processor array for machine learning in IoT devices,” in

2020 3rd International Conference on Data Intelligence and Security (ICDIS), IEEE, 2020, pp. 141–

147 (cited on pp. 17, 42).

[17] M. A. Kabir et al., “IMAGine: An In-Memory accelerated GEMV engine overlay,” in 2024 34th

International Conference on Field-Programmable Logic and Applications (FPL), Torino, Italy: IEEE, 2024, pp. 220–226. DOI: 10.1109/FPL64840.2024.00038 (https://doi.org/10.1109/FPL64840.2024.00038) (cited on pp. 17, 42).

[18] M. Horowitz, “1.1 computing’s energy problem (and what we can do about it),” in IEEE International Solid-State Circuits Conference (ISSCC), 2014, pp. 10–14. DOI: 10 . 1109 / ISSCC .

2014.6757323 (https://doi.org/10.1109/ISSCC.2014.6757323) (cited on p. 18).

[19] Y. LeCun et al., “Gradient-based learning applied to document recognition,” Proceedings of the IEEE, vol. 86, no. 11, pp. 2278–2324, 1998. DOI: 10.1109/5.726791 (https://doi.org/10.1109/5.726791) (cited on p. 18).
[20] L. Deng, “The MNIST database of handwritten digit images for machine learning research

[best of the web],” IEEE Signal Processing Magazine, vol. 29, no. 6, pp. 141–142, 2012. DOI:
10.1109/MSP.2012.2211477 (https://doi.org/10.1109/MSP.2012.2211477) (cited on p. 18).
[21] TUL Corporation, PYNQ-Z2 FPGA Development Board, https://www.tulembedded.com/

FPGA/ProductsPYNQ-Z2.html, (https://www.tulembedded.com/FPGA/ProductsPYNQ-Z2.html) Accessed: 2026-04-14, n.d. (Cited on p. 19).

[22] AMD, 7 series fpgas configurable logic block user guide (ug474), Advanced Micro Devices, 2025. Accessed: Apr. 14, 2026. [Online]. Available: https://docs.amd.com/r/en-US/
ug474_7Series_CLB/CLB/Slice-Configurations (https://docs.amd.com/r/en-US/ug474_7Series_CLB/CLB/Slice-Configurations) (cited on p. 19).

## Appendices

## A Preliminary Project Proposal

### A.1 Background

Image processing is the core workload of various edge systems. 2D convolution is the fundamental

operation found in low-level vision and convolutional neural network (CNN) tasks. This is where

a weighted sum of a pixel and its neighbours are repeated across the entire image. A single 3×3

convolution on a modest 256×256 image already requires over half a million multiply-accumulate

(MAC) operations, and modern CNNs scale this by orders of magnitude through multiple stacked

convolutional layers and feature channels. Executing such workloads on conventional sequential

processors is very inefficient. Pipelining, superscalar issue, and out-of-order execution all target

instruction-level parallelism, but they do not exploit the property that the same operation is ap-

plied independently to many data elements.

### A.2 Motivation

Single-Instruction-Multiple-Data (SIMD) array processors exploit this property directly. A grid of

processing elements (PEs) executes one shared instruction across many pixels in parallel, elimi- nat-

ing the per-instruction fetch and decode cost. When the array is connected through nearest- neigh-

bour links, the spatial structure of convolution maps onto the hardware without the need for global

memory access.

### A.3 Aim

The aim of this project is to design, implement, and evaluate an FPGA-based bit-serial SIMD array

processor capable of executing image-processing workloads.

### A.4 Objectives

1. Bit-serial processing element: Design a simple processing element comprising a bit-serial ALU

supporting arithmetic and boolean logic alongside a bit-serial register file. Success is defined as a functionally correct Processing Element (PE) that passes testcases across all supported

ALU operations and performs proper reads and writes to the register file, while achieving a

per-PE slice and Look-Up-Table (LUT) footprint competitive with prior bit-serial FPGA designs.

2. Scalable NEWS-connected array: Replicate the PE into a two-dimensional grid with North,

East, West, South (NEWS) connectivity, with a configurable boundary padding scheme and PE

activity gating for inactive elements. Success is defined as fitting a large array configuration,

sized against current bit-serial processors, within the available resources, delivering through-

put in GOPS that scales with PE count while keeping dynamic power consumption (in mW)

low enough to yield a competitive GOPS/mW figure.

3. Hardware control unit and instruction set architecture: Develop an FSM-based controller

with a minimal instruction set sufficient to run complex workloads, sequence bit-serial PE ex-

ecution, and provide a ready/valid handshake to the host. Success is defined as full ISA cov-

erage through workload execution, with the controller correctly driving all datapath control

signals.

4. ARM-host system integration: Connect the array processor to the ARM Cortex-A9 on the PYNQ-

Z2 using AXI-Lite for instruction delivery and a true-dual-port BRAM for data exchange. Suc-

cess is defined as a working host-accelerator system in which C programs running on the ARM

core can issue instructions and read back results, with the integration logic fitting within the

target device alongside the full array.

5. Application demonstration and evaluation: Implement two image processing workloads on

the completed system: a 3x3 Sobel edge-detection filter and a shallow convolutional neural

network for MNIST digit classification. Success is defined as both workloads producing the ex-

pected results: visible edges in the Sobel output and predicted digits matching the input la-

bels.

## B Project Plan and Gantt Chart

The section that follows lays out the project plan and the Gantt charts for semesters one and two

(shown in figure 15 , 16)

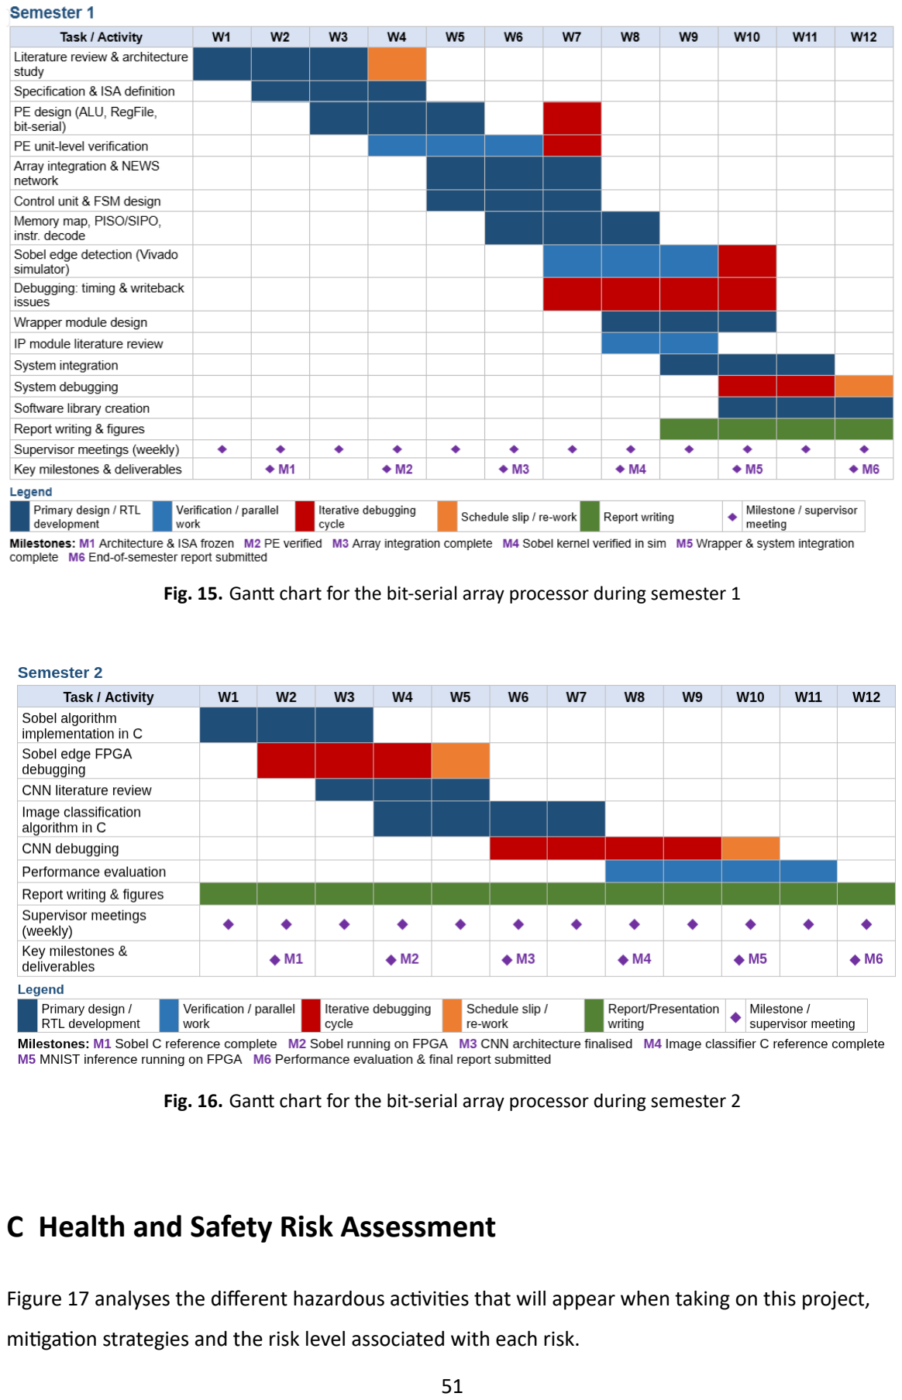
[picture p29: page 51]

Fig. 15. Gantt chart for the bit-serial array processor during semester 1

Fig. 16. Gantt chart for the bit-serial array processor during semester 2

## C Health and Safety Risk Assessment

Figure 17 analyses the different hazardous activities that will appear when taking on this project,

mitigation strategies and the risk level associated with each risk.


Fig. 17. Risk Assessment Form

## D Risk Register

Figure 18 shows the associated risks that will affect the progression of the project.

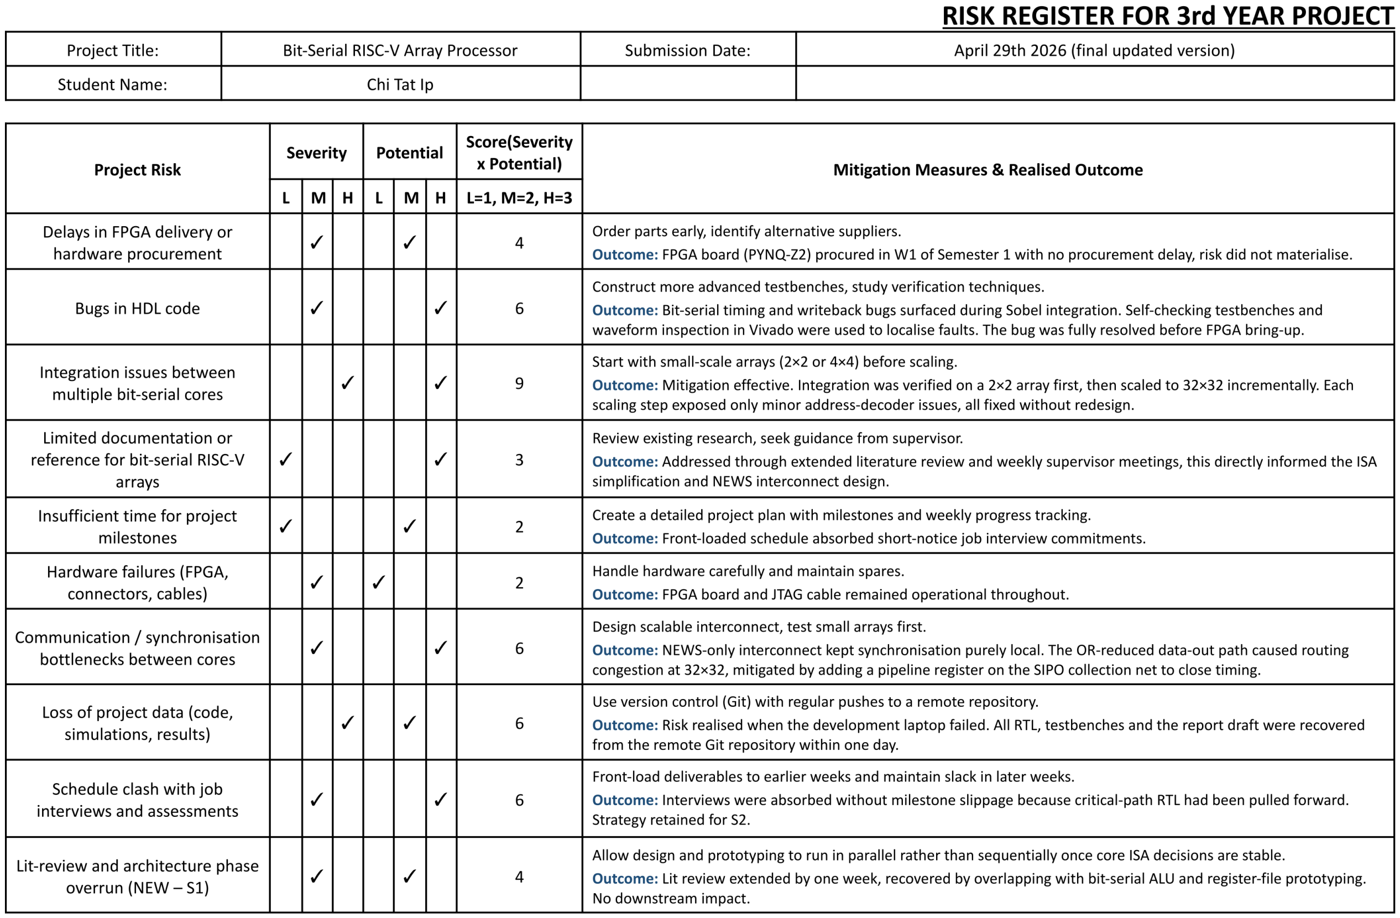
[picture p30: figure]

Fig. 18. Risk Register

## E Continuing Professional Development Log

The Continuing Professional Development (CPD) log shown in Figure 19 summarises the technical

learning activities that have been taken already and those that are planned for the future.

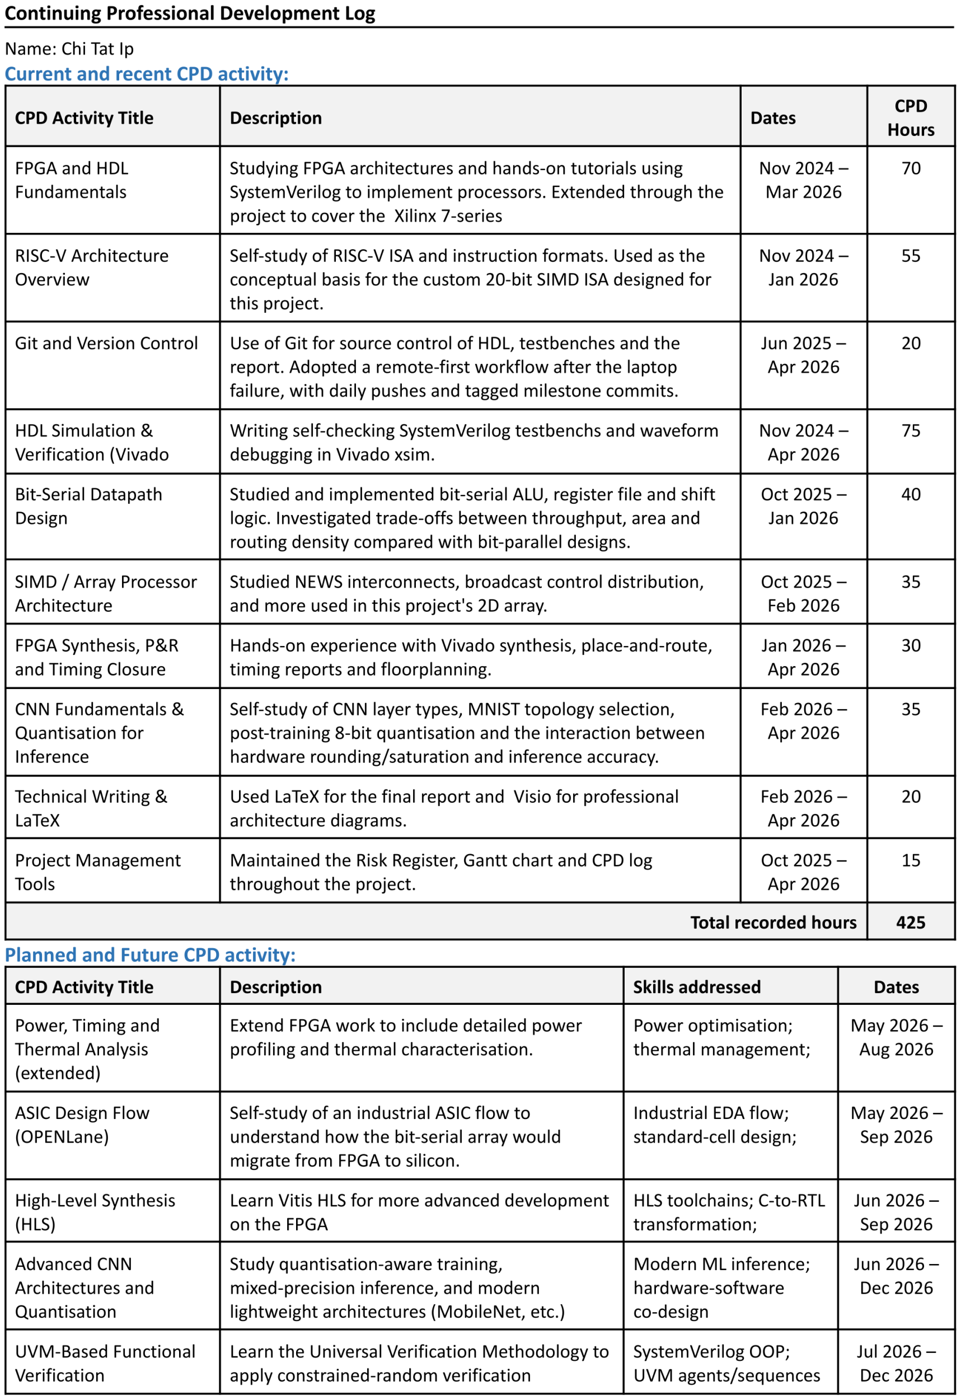
[picture p31: figure]

Fig. 19. Continuing Professional Development (CPD) log

## F Github Repository

The repository containing entire project is separated into two repositories. The repository name

”Individual-Project” contains the SystemVerilog design of my array processor, verification directo-

ries, and custom IPs. The repository labeled ”Individial_Project_System” contains the hardware de-

scription for the system level design as well as the C program used to communicate with the array

processor through the ARM processor to run image classification.

## Array Processor: https://github.com/adho-bot/Individual_Project System Design and Software: https://github.com/adho-bot/Individual_Project_System

## G Derivation of the General Movement-Based Convolution Formula

For a continuous image f(x, y) and a kernel h(x, y), the two-dimensional convolution is defined as

(f ∗ h)(x, y) = ∫︂ ∞

−∞

∫︂ ∞

−∞

f(u, v) h(x − u, y − v) du dv | (G.1)

For a digital image I(x, y) and discrete kernel K[m, n] of size M x N, the convolution becomes

C(x, y) = ∑︂

p

m=−p

∑︂

q

n=−q

km,n I(x − m, y − n), p =

M − 1
2

, q =

N − 1
2

(G.2)

For a 3x3 kernel where M = N = 3 and p = q = 1, Equation ((G.2)) becomes

C(x, y) = ∑︂

1

i=−1

∑︂

1

j=−1

ki,j I(x + j, y + i) | (G.3)

Expanding Equation ((G.3)) yields

C(x, y) = k−1,−1I(x − 1, y − 1) + k−1,0I(x, y − 1) + k−1,1I(x + 1, y − 1)

+ k0,−1I(x − 1, y) + k0,0I(x, y) + k0,1I(x + 1, y)

+ k1,−1I(x − 1, y + 1) + k1,0I(x, y + 1) + k1,1I(x + 1, y + 1)

(G.4)

## H Array Processor Implementation of the Sobel Kernels

Sobel edge detection uses two kernels that estimate the horizontal and vertical image gradients

Gx =

⎡

⎢
⎢
⎢
⎣

−1 0 1

−2 0 2

−1 0 1

⎤

⎥
⎥
⎥
⎦

Gy =

⎡

⎢
⎢
⎢
⎣

−1 −2 −1

0 | 0 | 0
1 | 2 | 1

⎤

⎥
⎥
⎥
⎦

(H.1)

Applying Equation ((G.3)) to the horizontal kernel Gx and ignoring zero terms gives

Gx(x, y) = (−1)I(x − 1, y − 1) + 1I(x + 1, y − 1)

+ (−2)I(x − 1, y) + 2I(x + 1, y)

+ (−1)I(x − 1, y + 1) + 1I(x + 1, y + 1)

(H.2)

This expression can be rewritten as the difference between the east and west column contributions

Gx(x, y) = Ieast − Iwest | (H.3)

where

Iwest = I(x − 1, y − 1) + 2I(x − 1, y) + I(x − 1, y + 1) | (H.4)
Ieast = I(x + 1, y − 1) + 2I(x + 1, y) + I(x + 1, y + 1) | (H.5)

To avoid multiplication, the weighting factor of two can be produced using repeated summation of

shifted images. First, a partial vertical sum is constructed

B(x, y) = I(x, y) + I(x, y − 1) | (H.6)

Shifting this value south and adding again produces

C(x, y) = B(x, y) + B(x, y + 1) | (H.7)

Expanding Equation ((H.7)) gives

C(x, y) = I(x, y − 1) + 2I(x, y) + I(x, y + 1) | (H.8)

which reproduces the vertical Sobel weighting without requiring multiplication.

The horizontal gradient can therefore be computed as

Gx(x, y) = C(x + 1, y) − C(x − 1, y) | (H.9)

The same procedure applied to Gy yields the symmetric form, with east/west sums replacing north/-

south and the final difference taken between north and south neighbours.

## I Memory and Register Allocation for MNIST CNN Inference

Table 5. BRAM word-address memory map.

Region | Word Addresses Contents
Input image | 0 – 255 | Raw 16x16 pixel values
Pooled channel 0 256 – 304 | 7x7 max-pool output, filter 0
Pooled channel 1 320 – 368 | 7x7 max-pool output, filter 1

Table 6. PE register allocation during CNN inference.

Register Purpose
r0 | Hardwired zero (identity for add-based moves)
r1 | Input image pixel / pooling operand
r2 | Convolution accumulator
r3 | Neighbourhood operand (shifted neighbour value)
r4 | Shift temporary / comparison result
r5 | Convolution filter 1 post-ReLU output
r6 | Convolution filter 0 post-ReLU output
r7 | All-ones mask (0xFFFF)
