adho-bot/Individual-Project/Final_Report_Latex/images/ASMBL.png

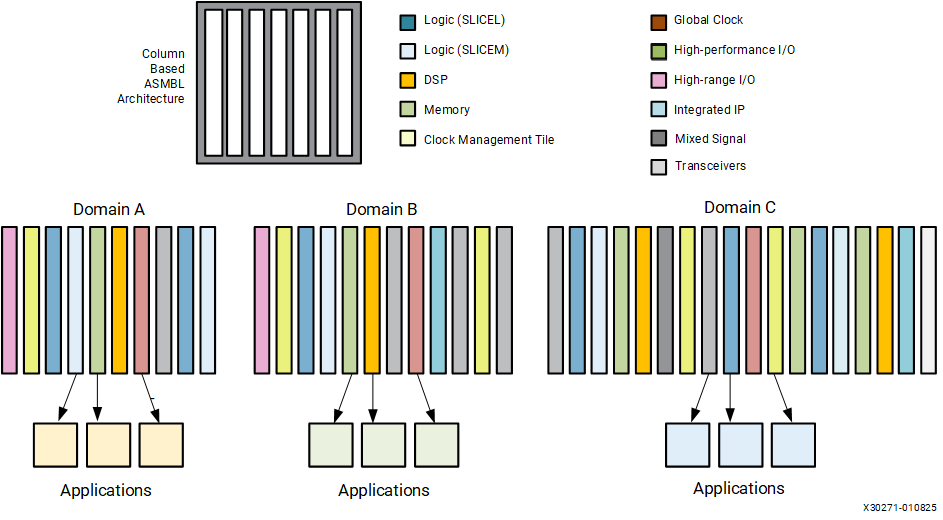
Final_Report_Latex/images/ASMBL.png
