adho-bot/Individual-Project/Final_Report_Latex/images/Instruction_Type.pdf

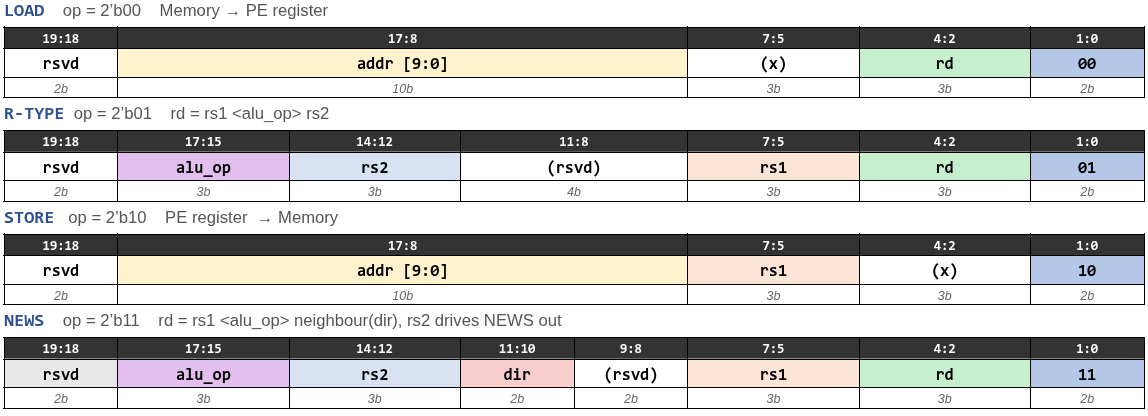
[picture p33: page 1]
