adho-bot/Individual-Project/Final_Report_Latex/images/RiskRegister.pdf

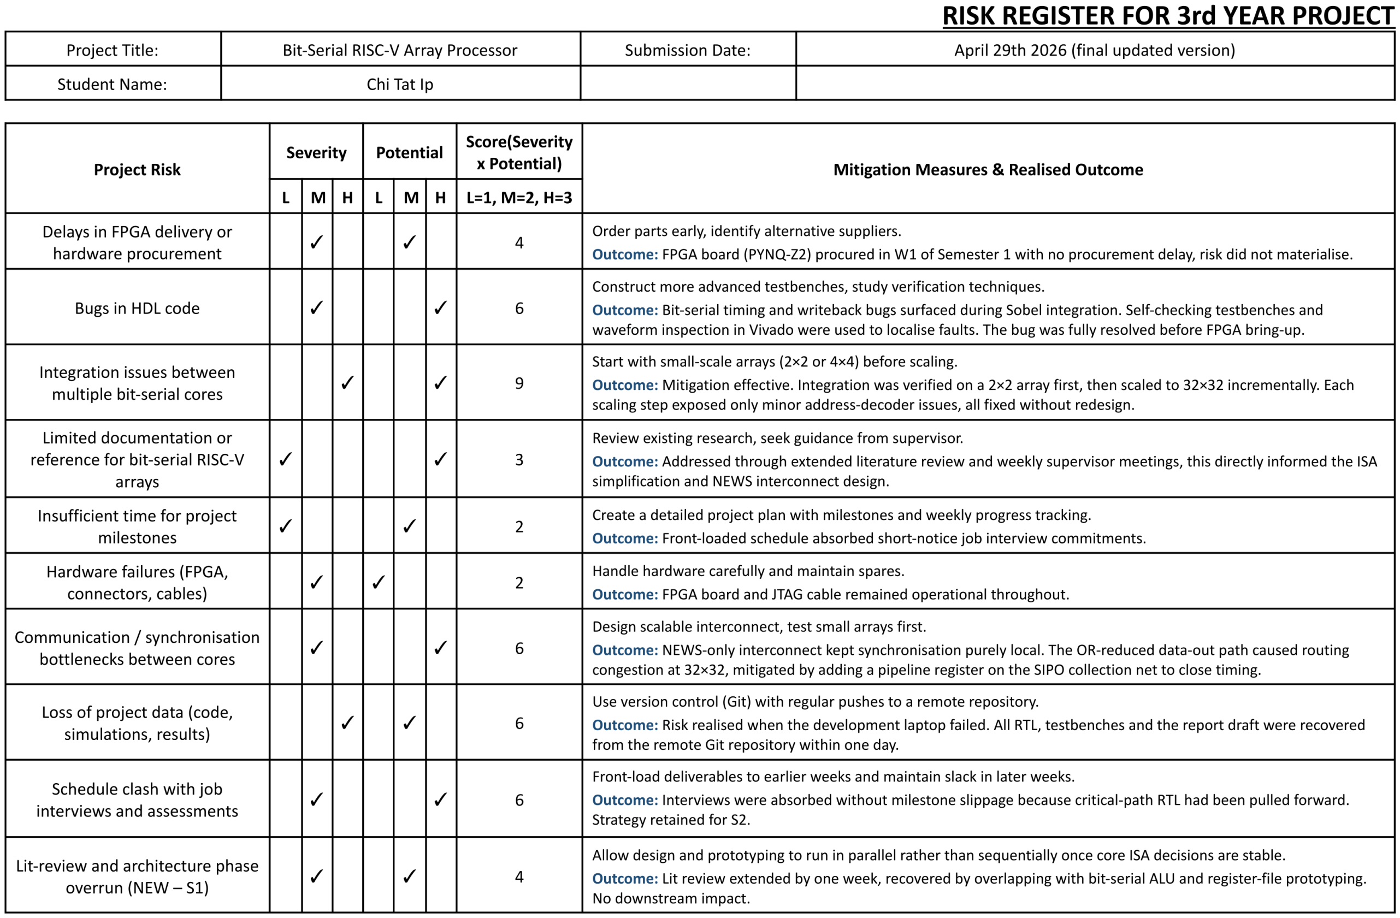
[picture p34: page 1]
