adho-bot/Individual-Project/Final_Report_Latex/images/LenaEye.pdf

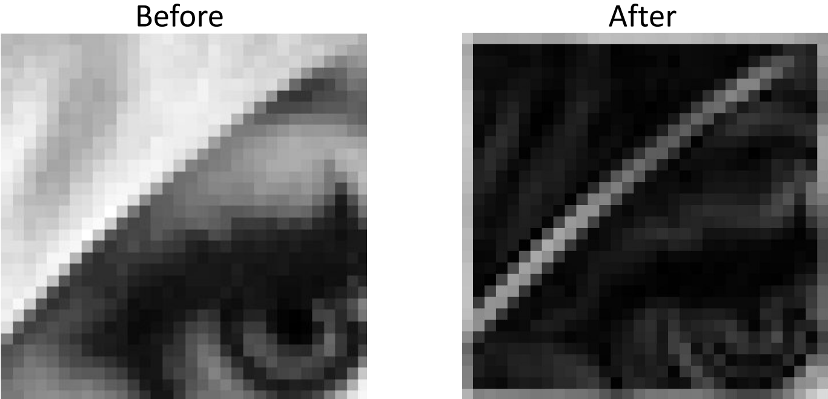
[picture p36: page 1]
