adho-bot/Individual-Project/Final_Report_Latex/images/MNIST.pdf

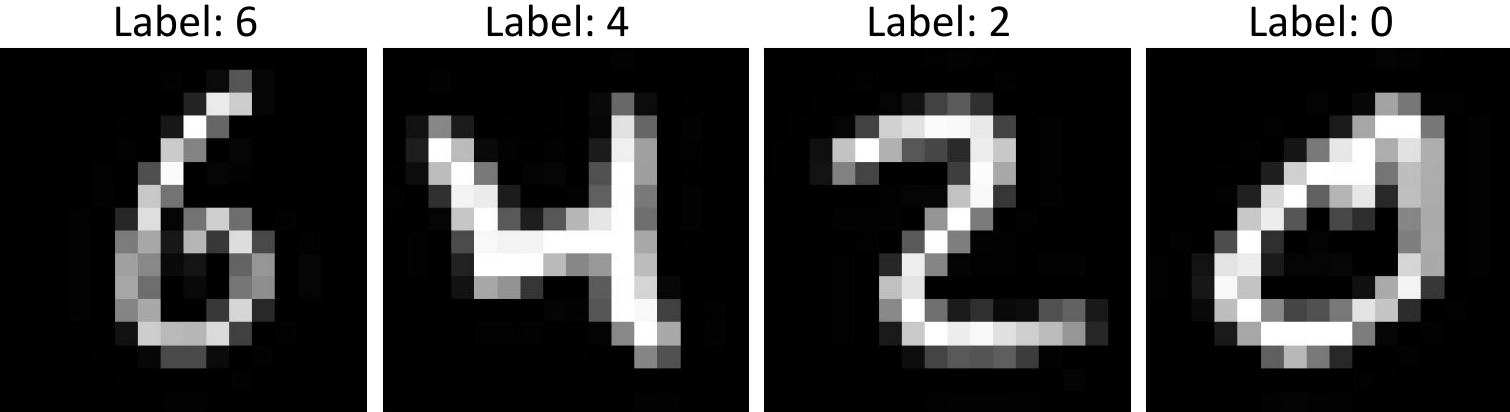
[picture p37: page 1]
