adho-bot/Individual-Project/Final_Report_Latex/images/MNIST_Eight.pdf

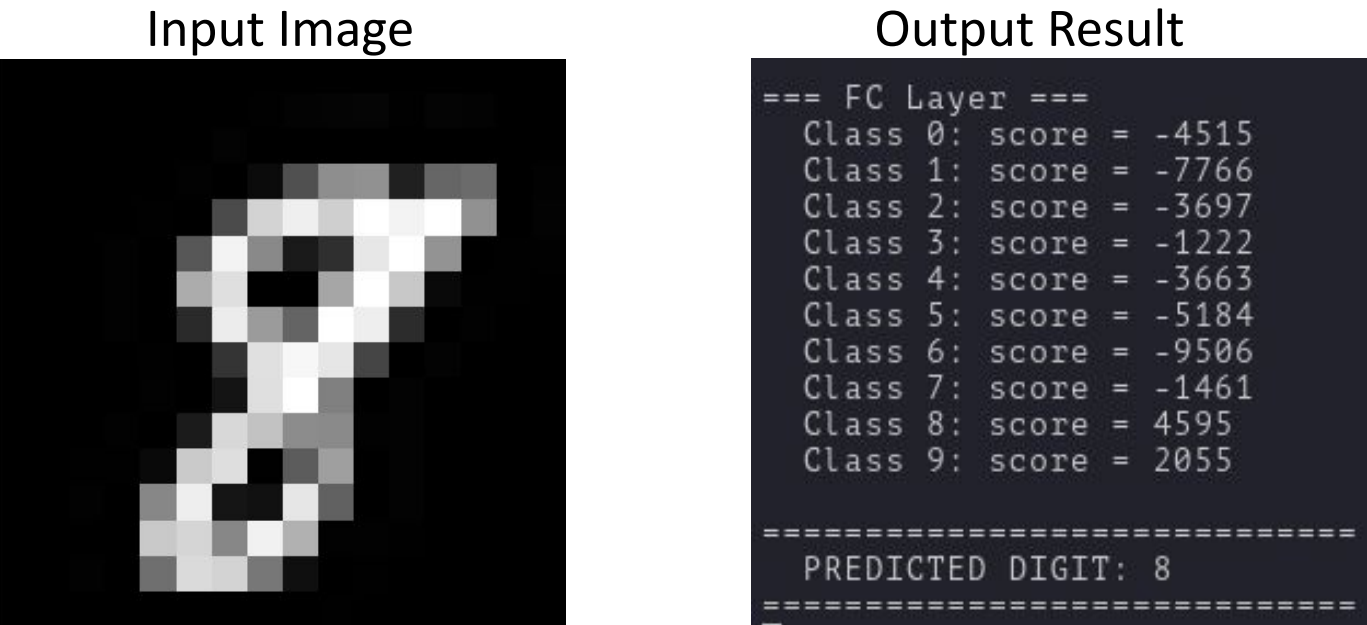
[picture p38: page 1]
