adho-bot/Individual-Project/ip/ipTop/src/Control_FSM.sv

`include "Definitions.sv"
`timescale 1ns/1ps

module Control_FSM#(
    parameter int DATA_WIDTH
    )(
    input   logic           i_clk,
    input   logic           i_rstn,
    input   logic [19:0]    i_instruction,  // instruction word (opcode + operands)
    
    //Instruction Handshaking
    input logic             i_instr_valid,
    
    output  logic [$clog2(DATA_WIDTH):0]     o_counter,      //sync counter

    output  logic [3:0]     o_state,
    
    output  logic           o_FSM_ready     //ready signal for next instruction to be sent
    
    
);

    // ───────────────────────────────────────────────
    // State encoding
    // ───────────────────────────────────────────────
    logic   [3:0]           next_state;


    // ───────────────────────────────────────────────
    // Counter Logic
    // ───────────────────────────────────────────────
    logic   [$clog2(DATA_WIDTH):0]           counter;
    assign  o_counter = counter;    



    // ───────────────────────────────────────────────
    // Sequential block - state register
    // ───────────────────────────────────────────────
    always_ff @(posedge i_clk or negedge i_rstn) begin
        if (!i_rstn)
            o_state <= `IDLE;
        else
            o_state <= next_state;
    end

    // ───────────────────────────────────────────────
    // Combinational block - next state logic
    // ───────────────────────────────────────────────
    always_comb begin
        case (o_state)
            `IDLE: begin
                if(i_instr_valid) begin
                    case(i_instruction[1:0])
                        `OP_LOAD:   next_state = `DATA_FETCH;
                        `OP_R_TYPE:  next_state = `R_EXECUTE;
                        `OP_STORE: next_state = `STORE_DATA;
                        `OP_NEWS_TYPE: next_state = `NEWS_EXECUTE;
                        default:   next_state = `IDLE;
                    endcase
                end else begin
                    next_state = `IDLE;
                end
            end
            
            `DATA_FETCH: begin
                next_state = `MEM_TO_DATA;
            end

            `DATA_LOAD: begin
                if(counter < DATA_WIDTH - 1) begin
                    next_state = `DATA_LOAD; // fallback
                end else begin
                    next_state = `IDLE;
                end
            end

            `R_EXECUTE: begin
                if(counter < DATA_WIDTH - 1) begin
                    next_state = `R_EXECUTE; // fallback
                end else begin
                    next_state = `IDLE;
                end
            end
            
            `NEWS_EXECUTE: begin    //
                if(counter < DATA_WIDTH - 1) begin
                    next_state = `NEWS_EXECUTE; //
                end else begin
                    next_state = `IDLE;
                end
            end

            `STORE_DATA: begin
                if(counter < DATA_WIDTH - 1) begin
                    next_state = `STORE_DATA; 
                end else begin
                    next_state = `DATA_TO_MEM;
                end
            end
            
            `DATA_TO_MEM: begin         //sends accumulated 32bit data from SIPO to memory
                next_state = `IDLE;
            end
            
            `MEM_TO_DATA: begin
                next_state = `DATA_LOAD;
            end
   
            
            default: begin
                next_state = `IDLE;
            end

        endcase
    end

always_ff@(posedge i_clk or negedge i_rstn) begin
	if(!i_rstn) begin
		counter <= '0;
	end else if(o_state == `DATA_LOAD ||o_state == `R_EXECUTE ||
	            o_state == `NEWS_EXECUTE ||o_state == `STORE_DATA) begin
	               counter <= counter + 1;
	end else begin
	   counter <= '0;
	end
end

assign o_FSM_ready = (o_state == `IDLE) && (next_state ==`IDLE);

endmodule
