adho-bot/Individual-Project/(commit log)

2025-10-25 Currently designing control decode. organised module hierachy
2025-10-29 need to fix multiple driver issue
    [Array_main.sv, Control_Decode.sv, Control_FSM.sv, Control_unit.sv, Top.sv]
2025-10-30 Verifed control FSM. currently verifying control decode
2025-11-10 finished designing the row/col selector. Need to fix up memory now
    [Array_main.sv, Control_Decode.sv, Control_FSM.sv, Control_Unit_tb.sv, Control_unit.sv, Definitions.sv, Top.sv]
2025-12-18 corrected errors in testbench
    [KernelTest_tb.sv, Register_File.sv, Top_tb.sv]
2026-02-17 Simplified address decoder logic (Uses less complex circuits to implement now)
2026-02-17 fixed typo in array_main
    [Array_main.sv]
2026-02-17 Fixed latch in array_main
    [Array_main.sv]
2026-03-03 fixed issues and optimised register file
    [Array_main.sv, BMPnew.py, Control_Decode.sv, Control_FSM.sv, KernelTest_tb.sv, Register_File.sv, Top.sv, test.py]
2026-03-10 removed abs instruction and replaced it with MSB check
    [ALU_bitserial.sv, Array_main.sv, Control_Decode.sv, Control_FSM.sv, Control_unit.sv, Definitions.sv, IntrTest_tb.sv, KernelTest_tb.sv]
2026-03-24 fixed 1 off error
    [ALU_bitserial.sv, Control_Decode.sv, Control_FSM.sv, Control_unit.sv, KernelTest_tb.sv, PE_main.sv, Register_File.sv]
2026-04-14 fixed the large memory use issue
    [KernelTest_tb.sv, Postsim_Test.sv, Register_File.sv, Top.sv]
