adho-bot/Individual-Project/(notices)

Notices in the files:
Final_Report_Latex/main.tex:
\Copyrighted{True}
